UAH-IC-Design-Team/sky130-10-bit-SAR-ADC/images/capacitor_switch2.png

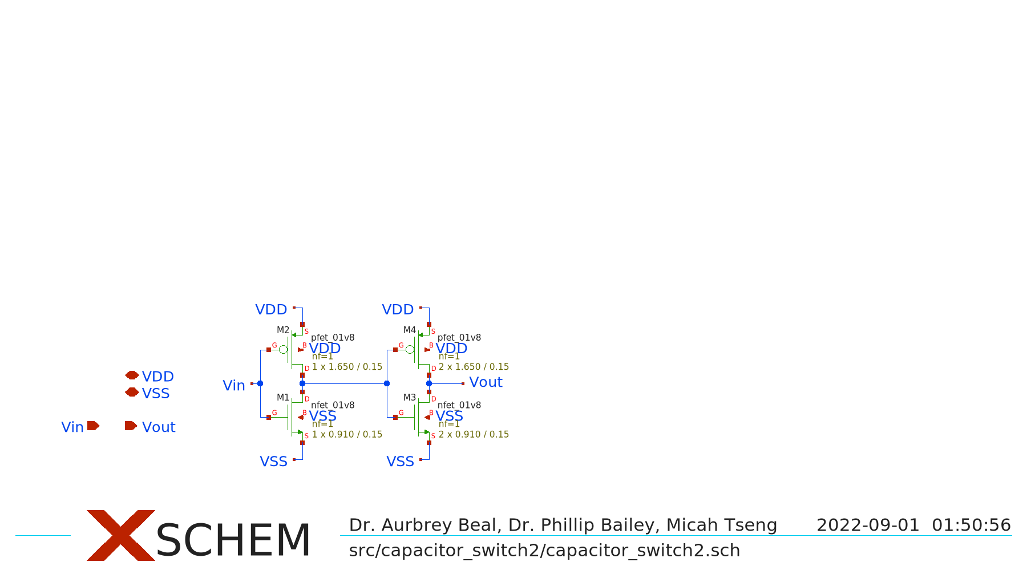
images/capacitor_switch2.png
