UAH-IC-Design-Team/sky130-10-bit-SAR-ADC/images/capacitor_switch8.png

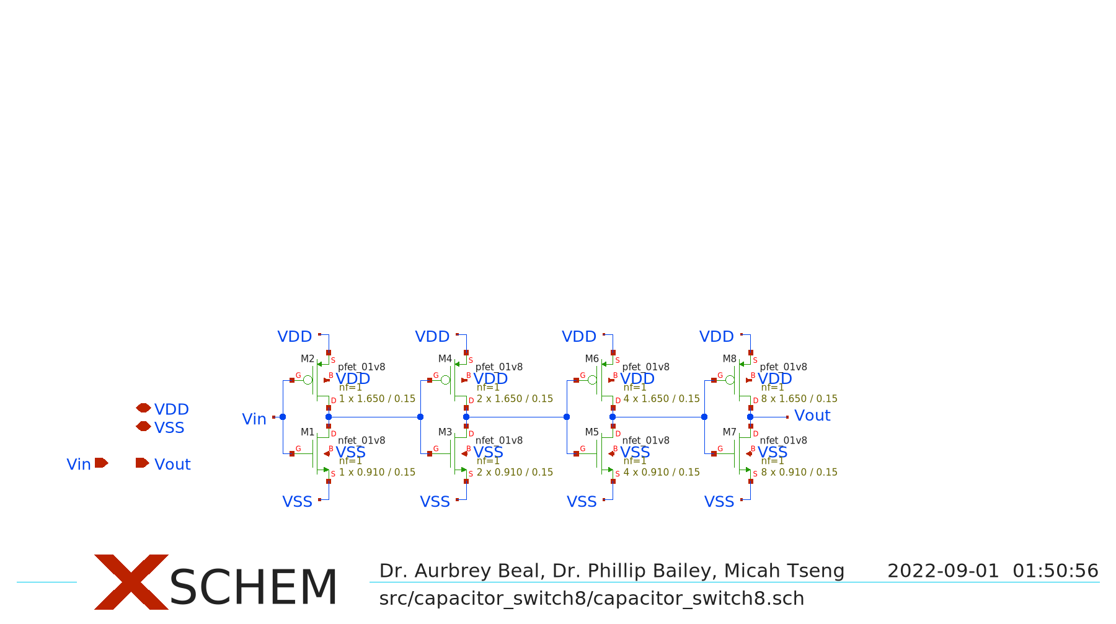
images/capacitor_switch8.png
