UAH-IC-Design-Team/sky130-10-bit-SAR-ADC/images/coherent_sine.png

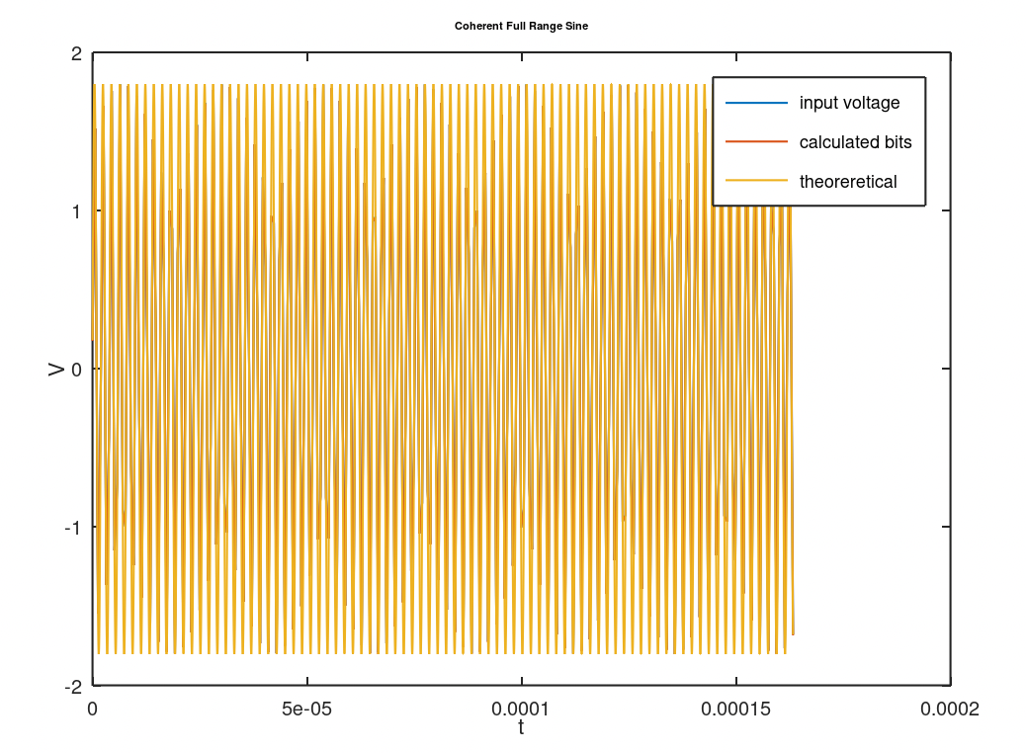
images/coherent_sine.png
