UAH-IC-Design-Team/sky130-10-bit-SAR-ADC/images/dac.png

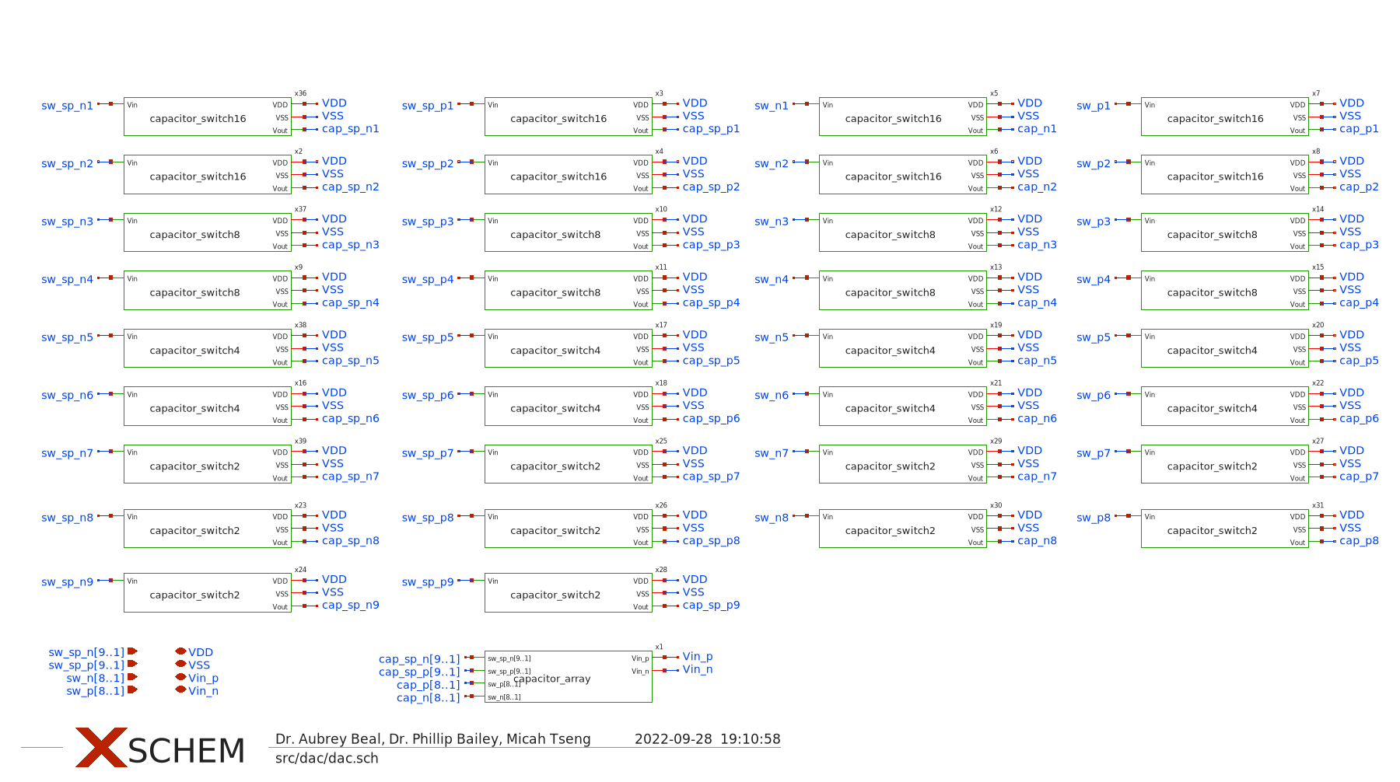
images/dac.png
