UAH-IC-Design-Team/sky130-10-bit-SAR-ADC/images/demux2.png

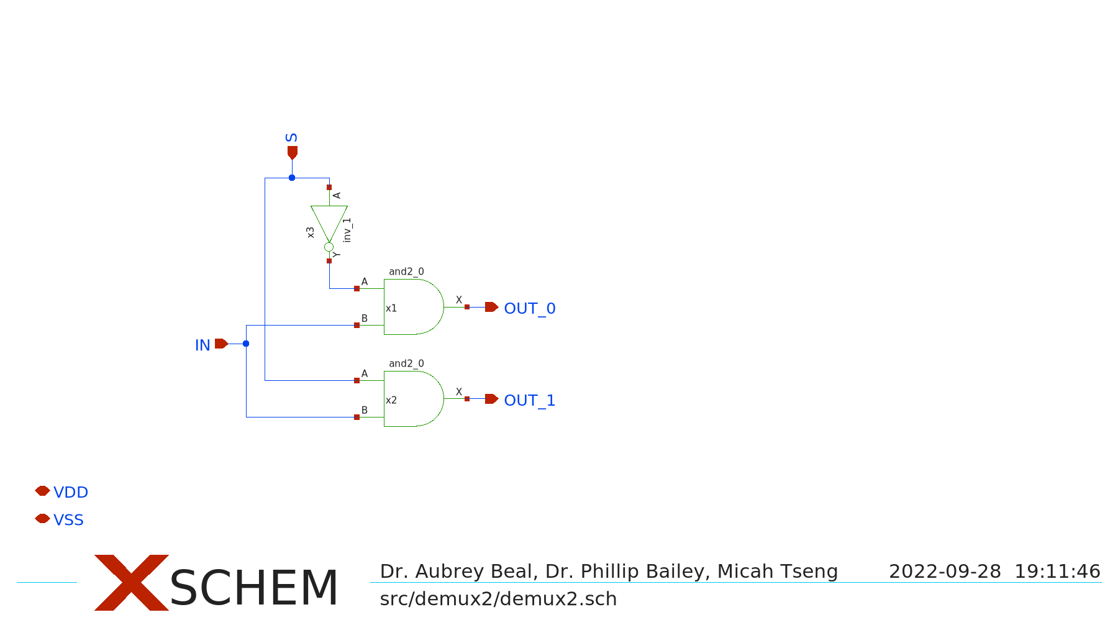
images/demux2.png
