UAH-IC-Design-Team/sky130-10-bit-SAR-ADC/images/raw_bit_calculato2r.png

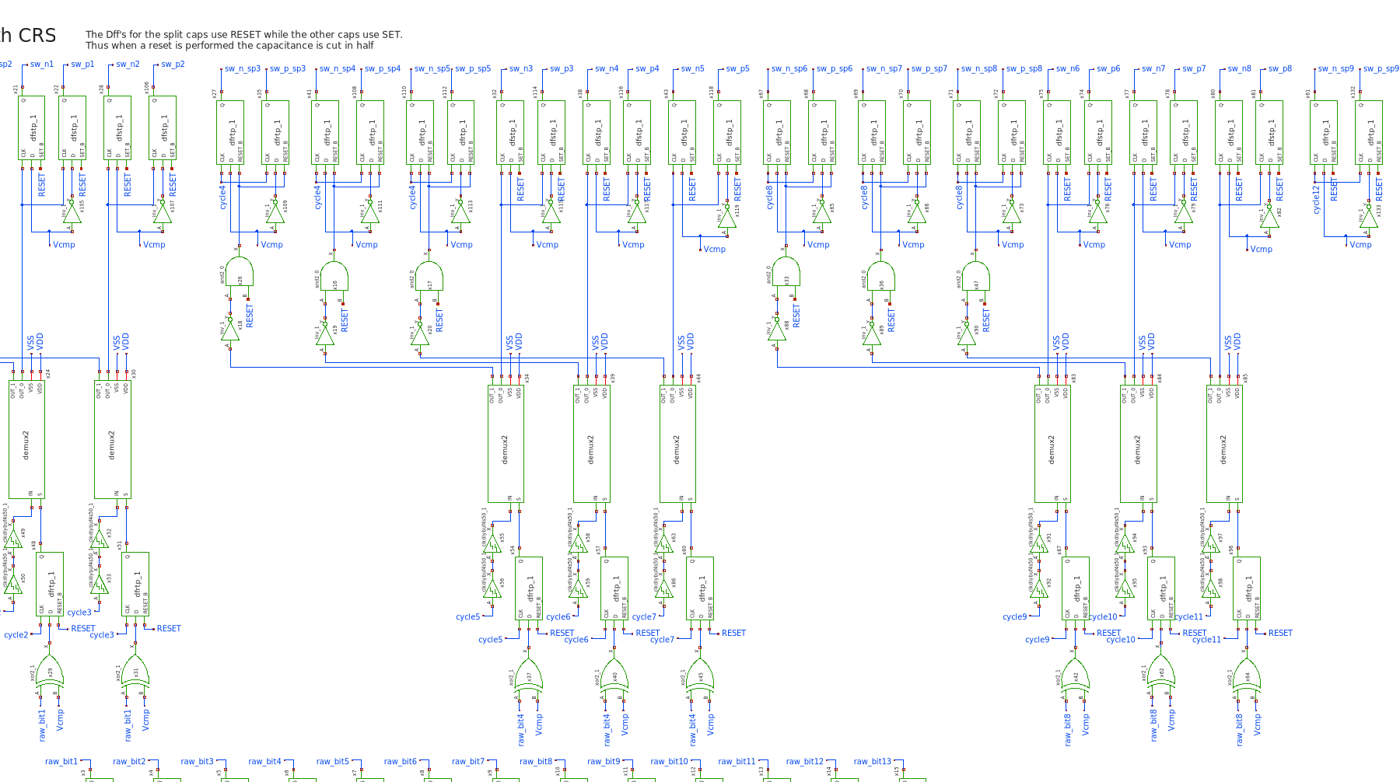
images/raw_bit_calculato2r.png
