UAH-IC-Design-Team/sky130-10-bit-SAR-ADC/images/raw_bit_calculator1.png

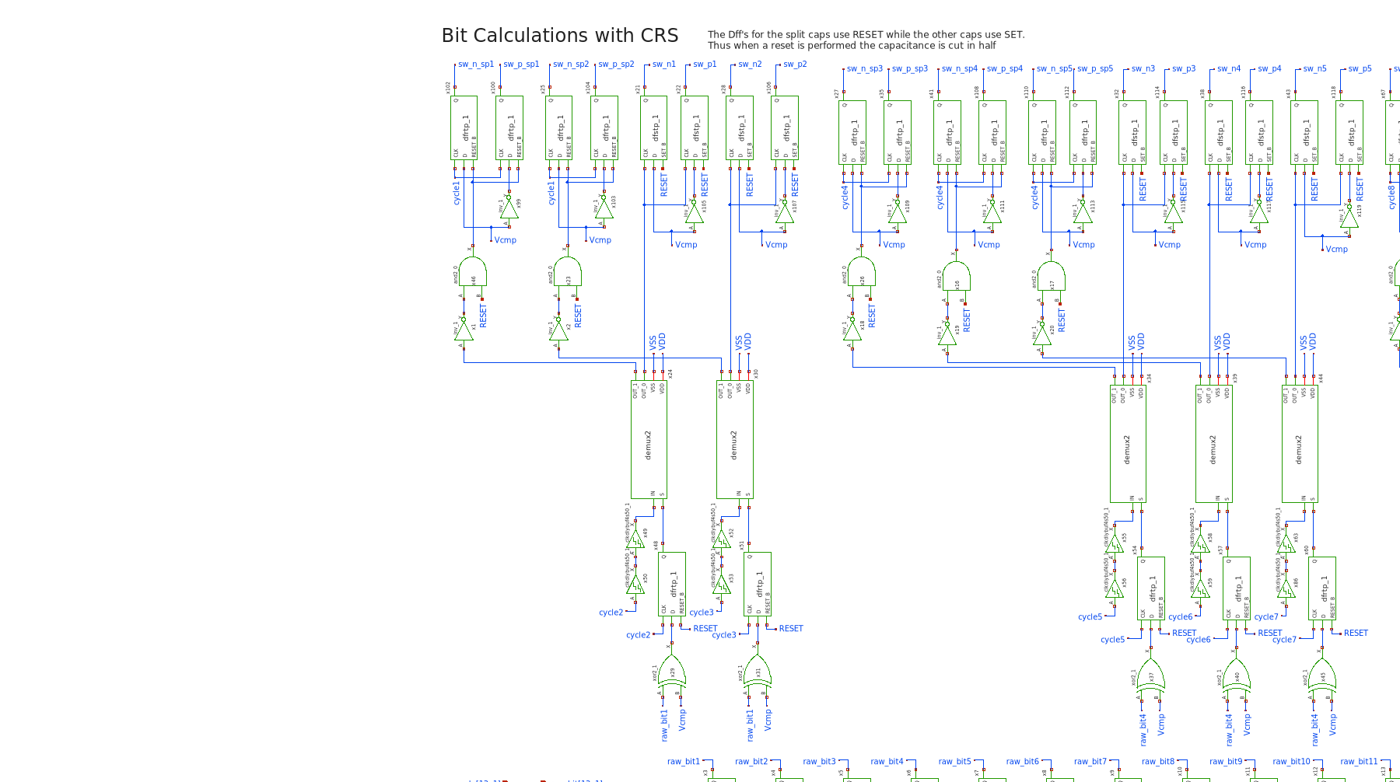
images/raw_bit_calculator1.png
