UAH-IC-Design-Team/sky130-10-bit-SAR-ADC/images/sar_adc.png

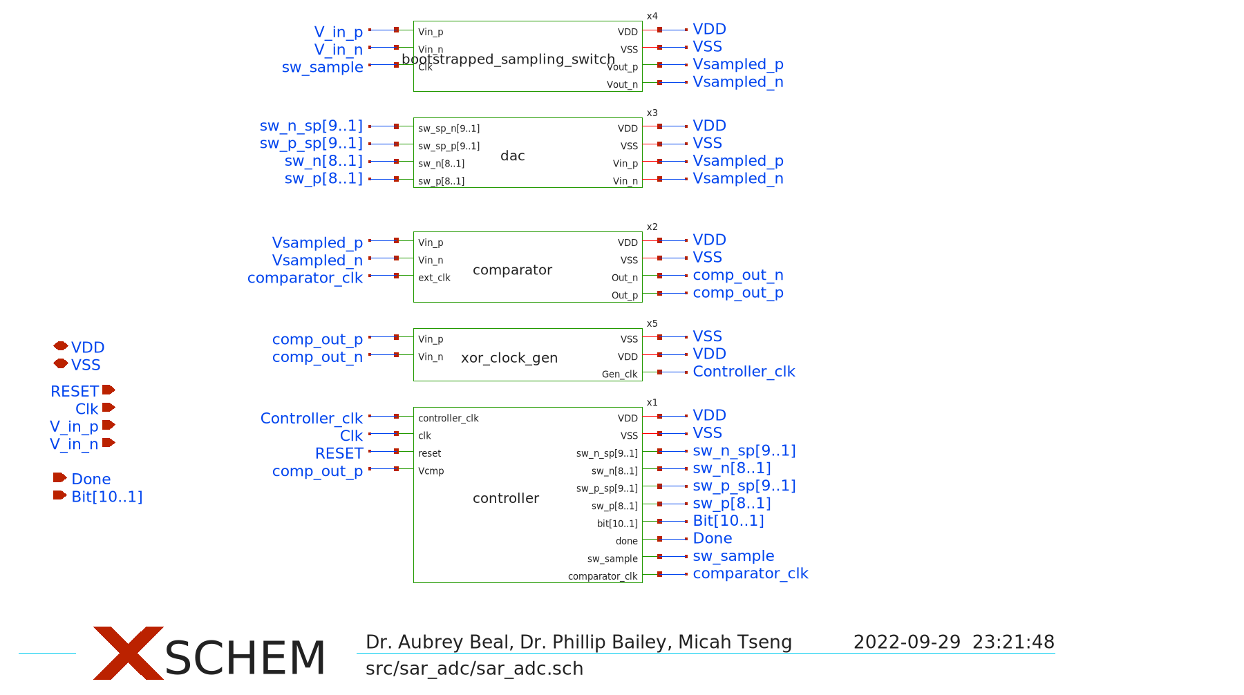
images/sar_adc.png
