UAH-IC-Design-Team/sky130-10-bit-SAR-ADC/images/bootstrapped_sampling_switch_test.png

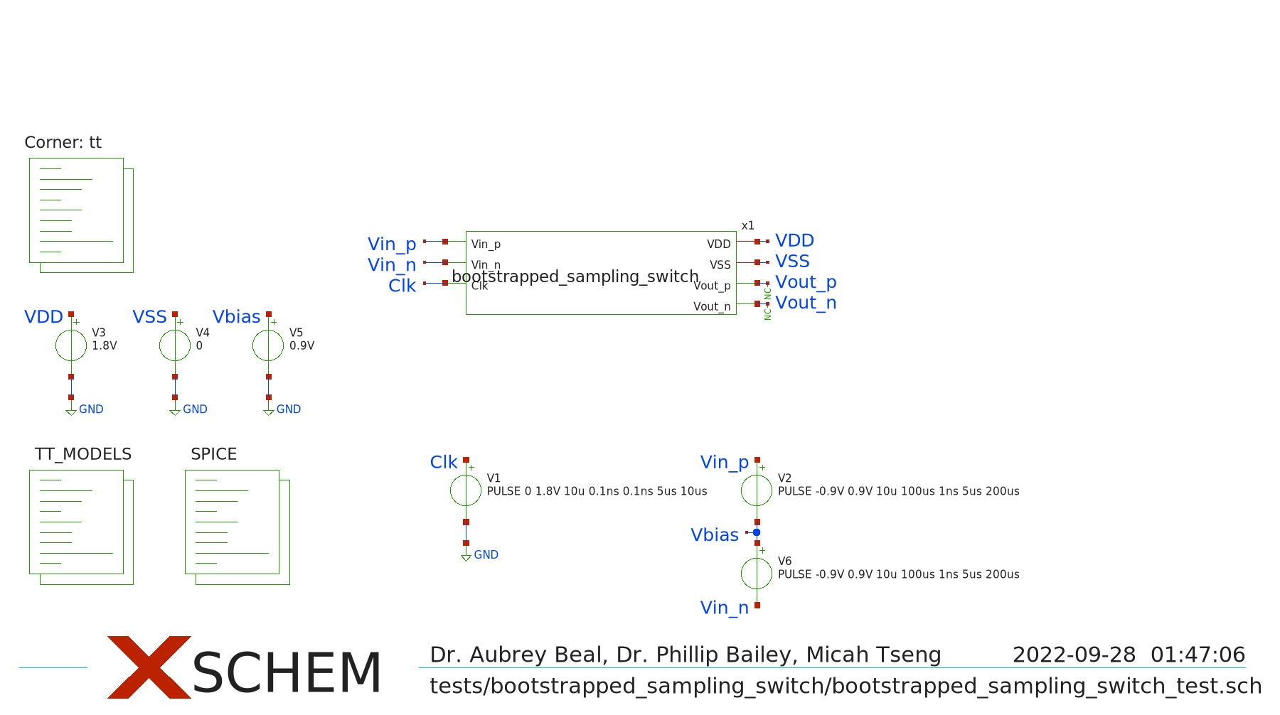
images/bootstrapped_sampling_switch_test.png
