UAH-IC-Design-Team/sky130-10-bit-SAR-ADC/images/capacitor_array_test.png

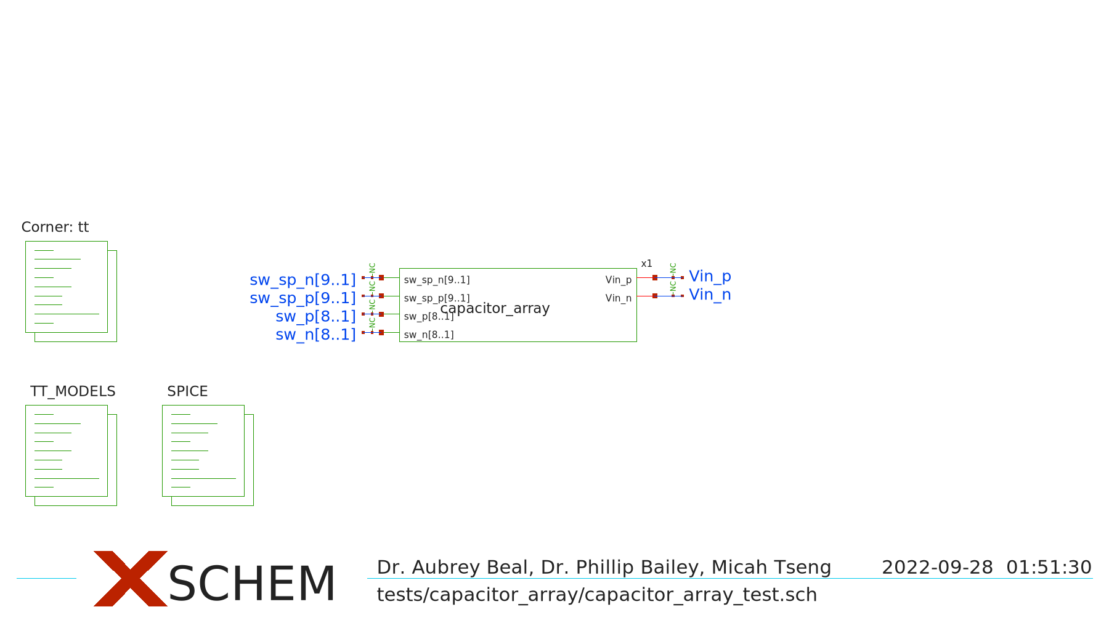
images/capacitor_array_test.png
