UAH-IC-Design-Team/sky130-10-bit-SAR-ADC/images/capacitor_switch2_test.png

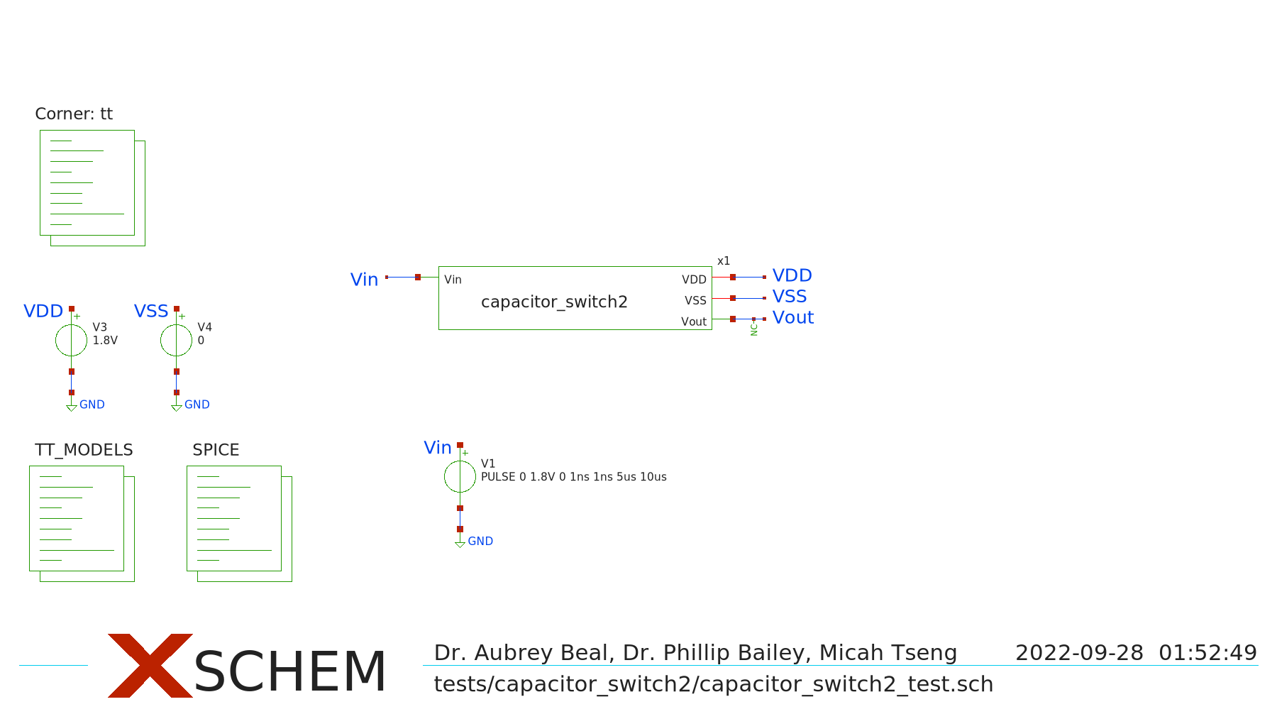
images/capacitor_switch2_test.png
