UAH-IC-Design-Team/sky130-10-bit-SAR-ADC/images/comparator_fast_small_v_test.png

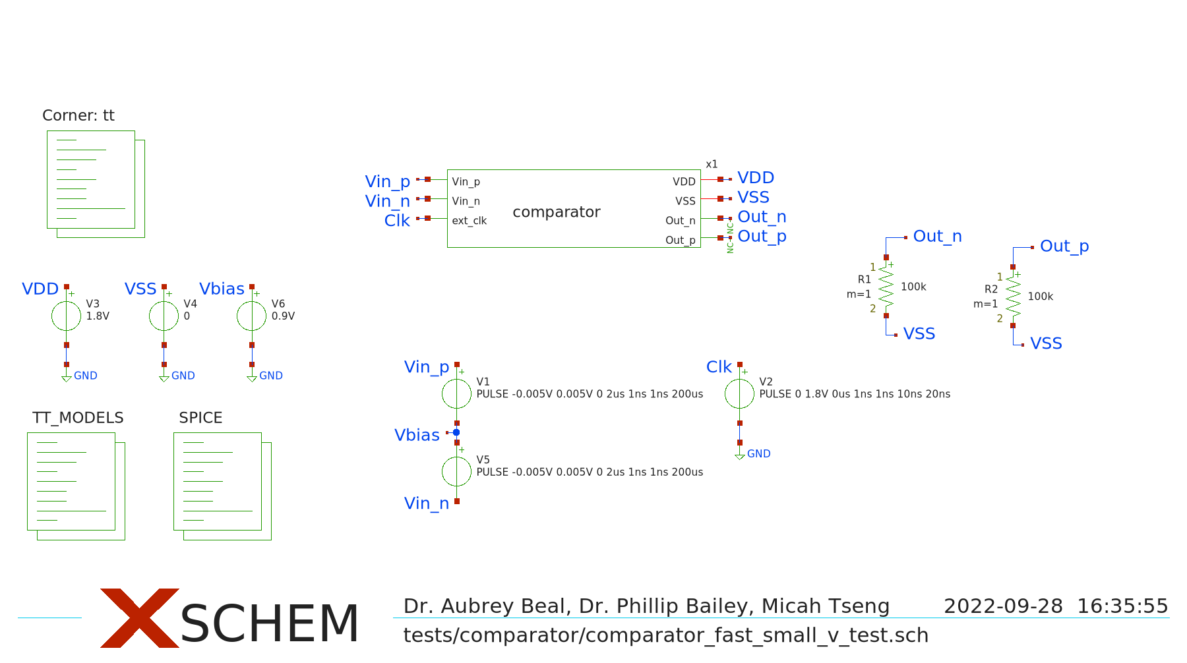
images/comparator_fast_small_v_test.png
