UAH-IC-Design-Team/sky130-10-bit-SAR-ADC/images/controller_corner_ff_test.png

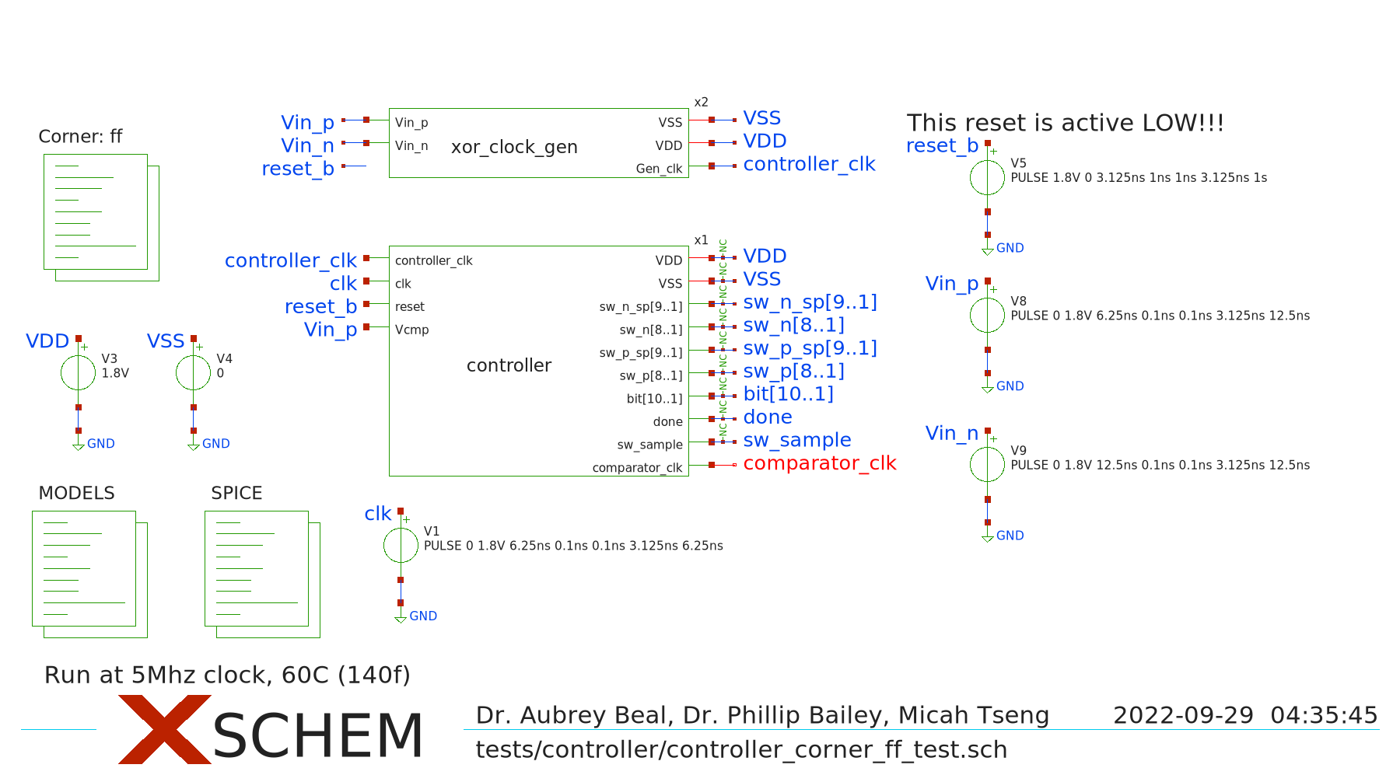
images/controller_corner_ff_test.png
