UAH-IC-Design-Team/sky130-10-bit-SAR-ADC/images/dac_test.png

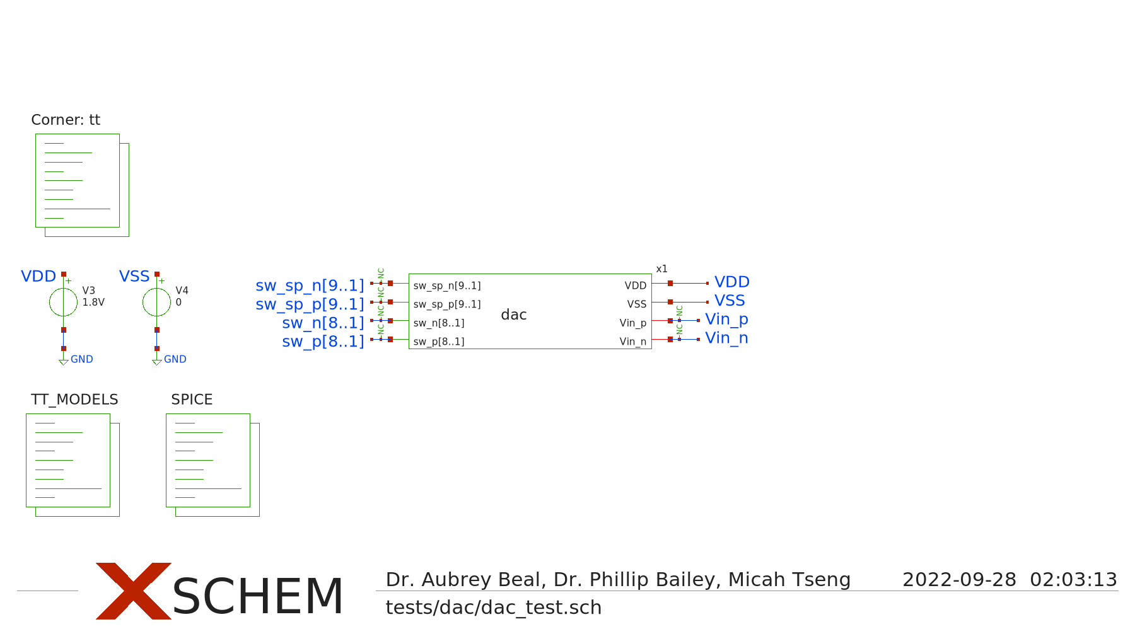
images/dac_test.png
