UAH-IC-Design-Team/sky130-10-bit-SAR-ADC/images/dec_test.png

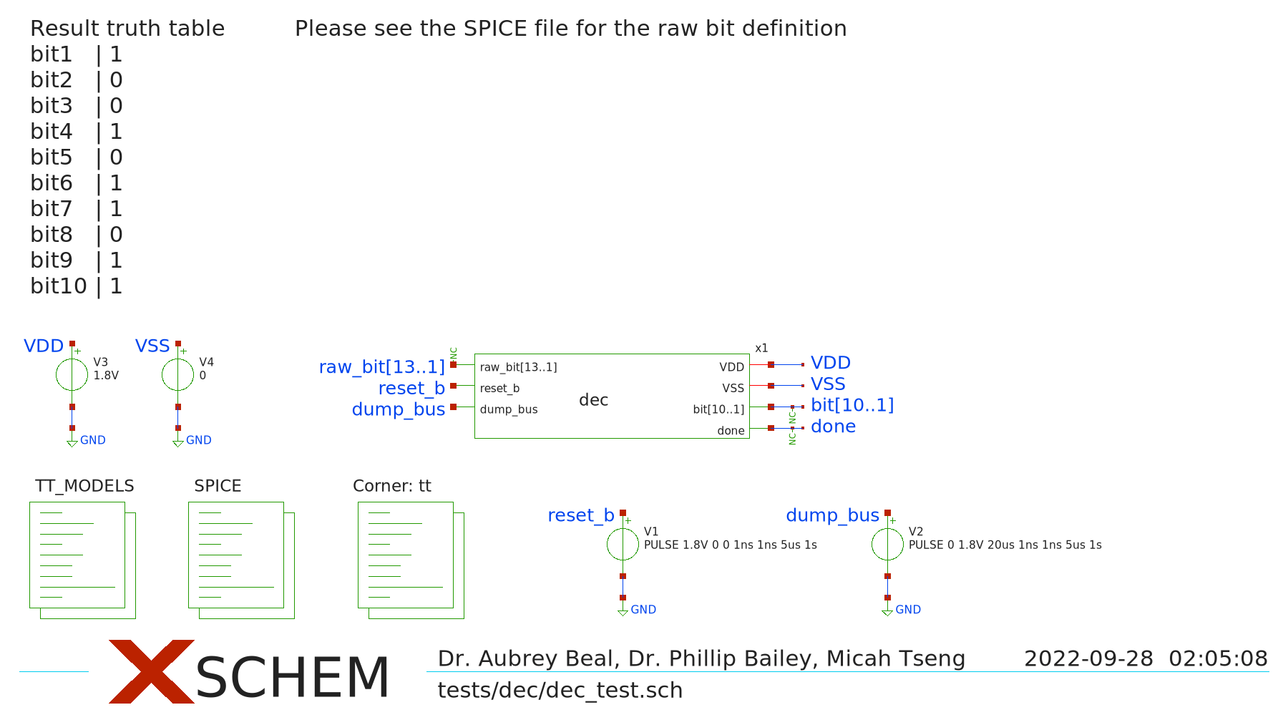
images/dec_test.png
