UAH-IC-Design-Team/sky130-10-bit-SAR-ADC/images/demux2_test.png

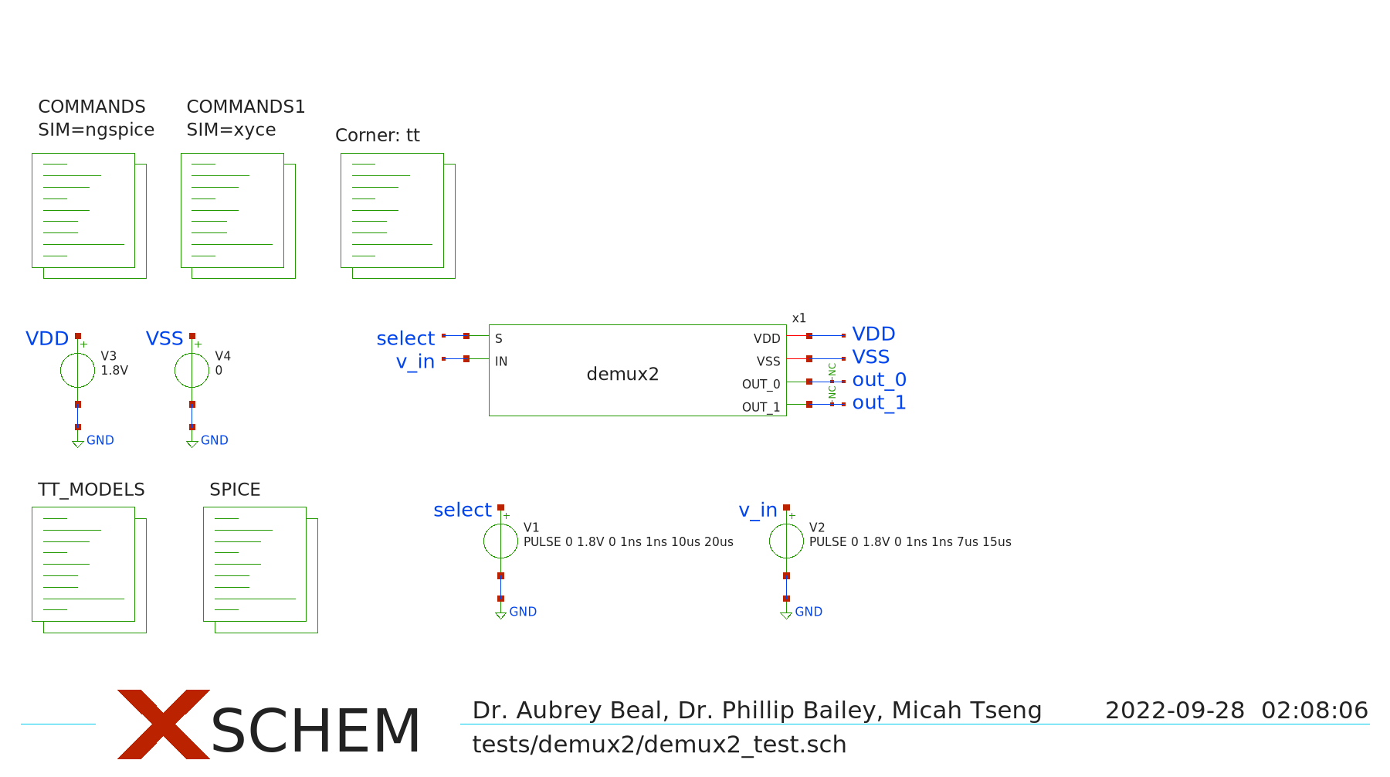
images/demux2_test.png
