UAH-IC-Design-Team/sky130-10-bit-SAR-ADC/images/raw_bit_calculator_test.png

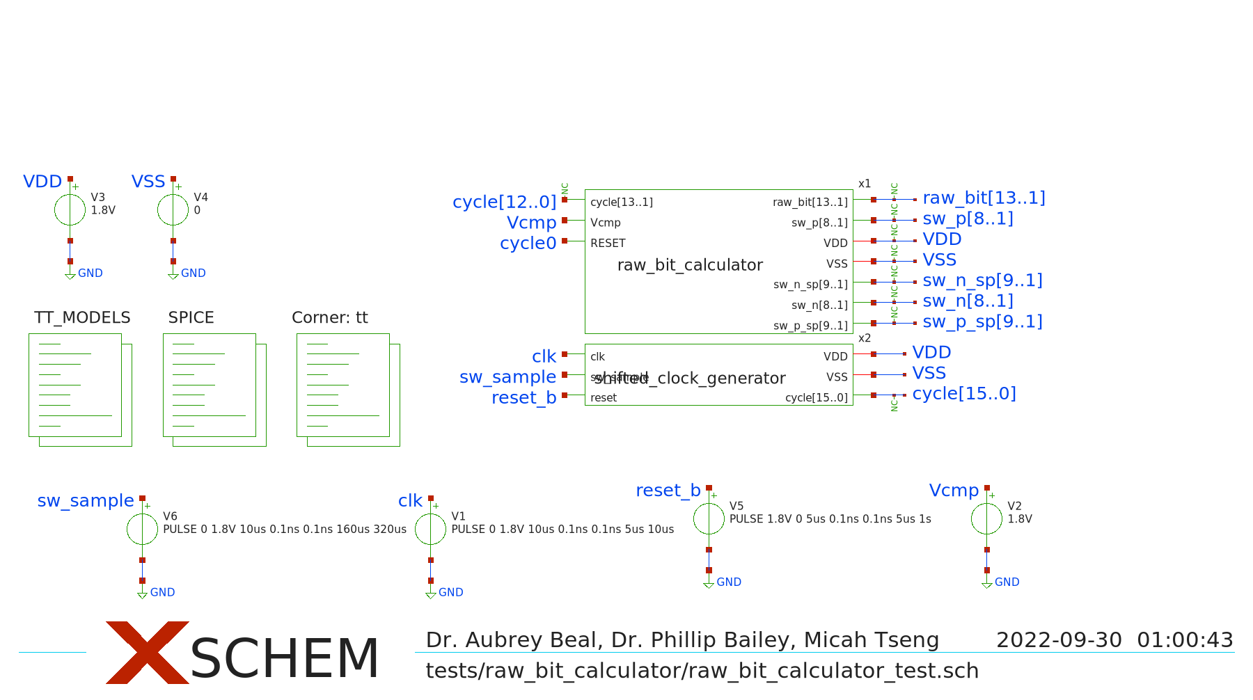
images/raw_bit_calculator_test.png
