UAH-IC-Design-Team/sky130-10-bit-SAR-ADC/images/sample_clock_test.png

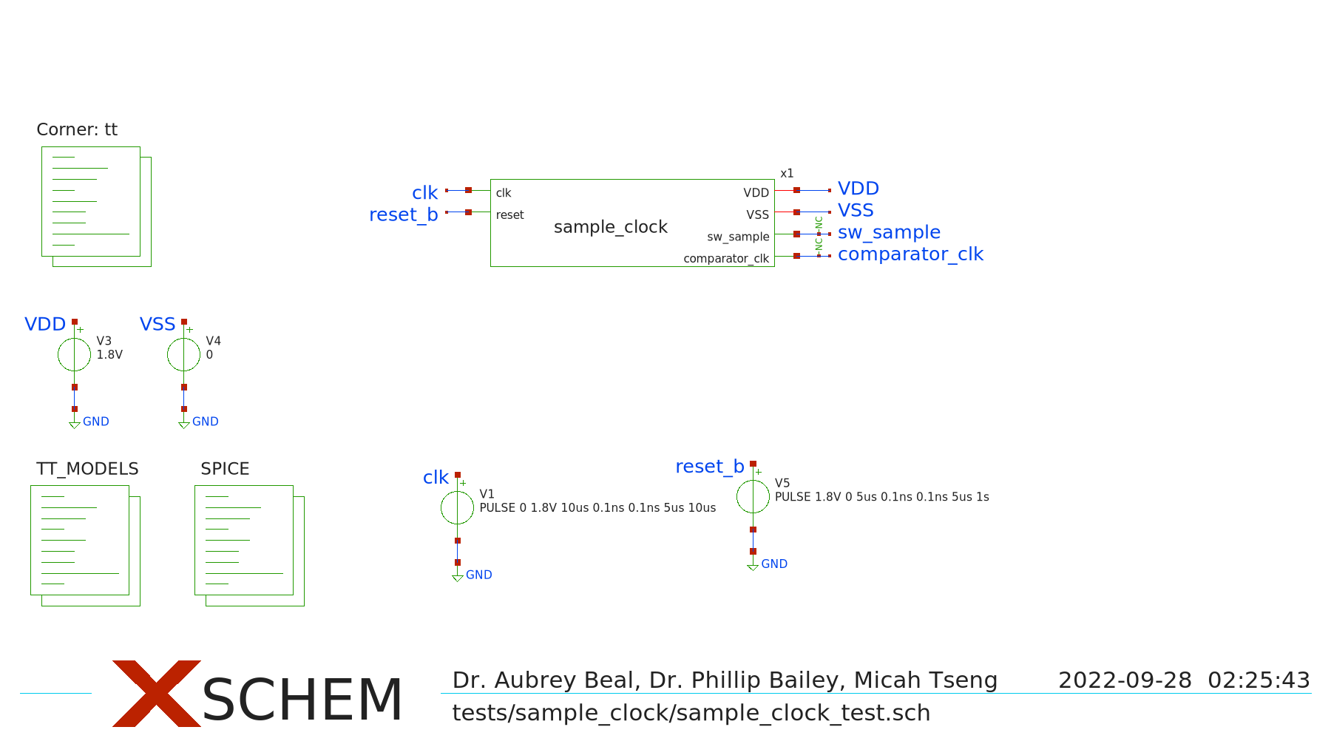
images/sample_clock_test.png
