UAH-IC-Design-Team/sky130-10-bit-SAR-ADC/images/sar_adc_code_step_test.png

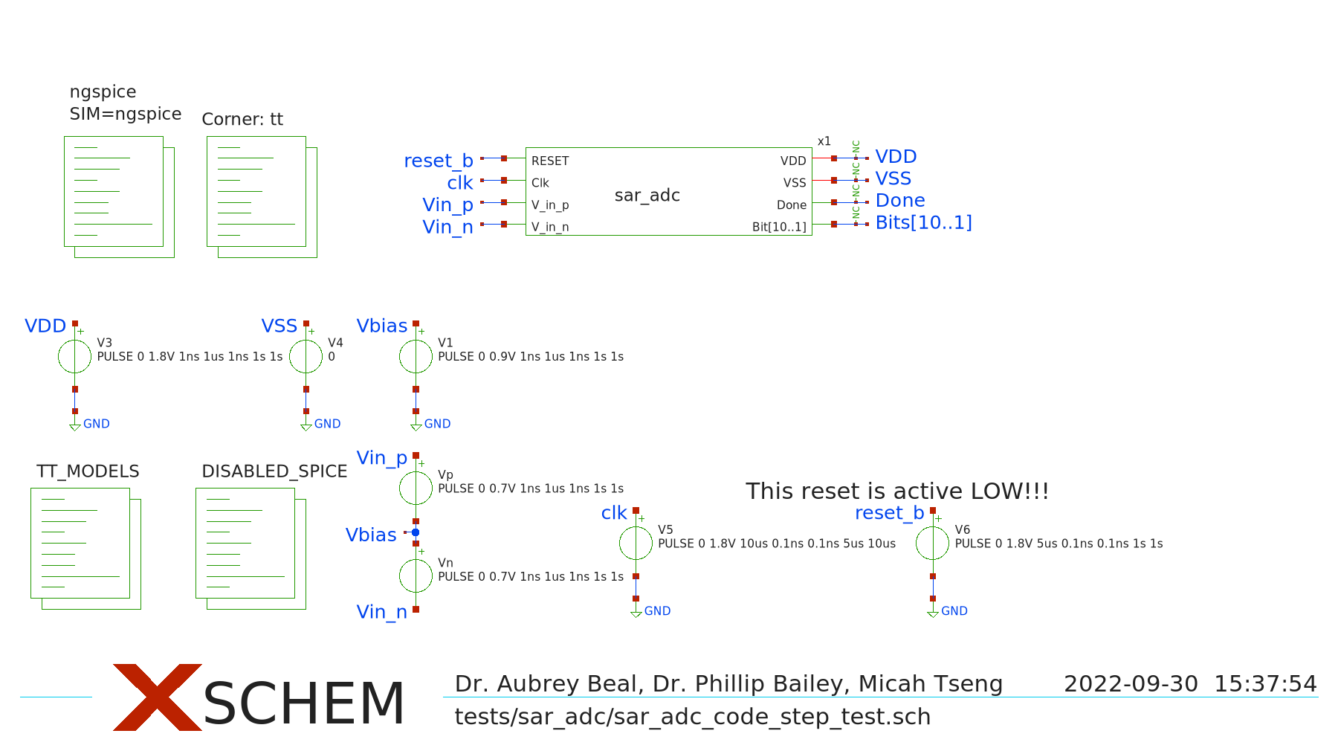
images/sar_adc_code_step_test.png
