UAH-IC-Design-Team/sky130-10-bit-SAR-ADC/images/sar_adc_max_sample_rate_test.png

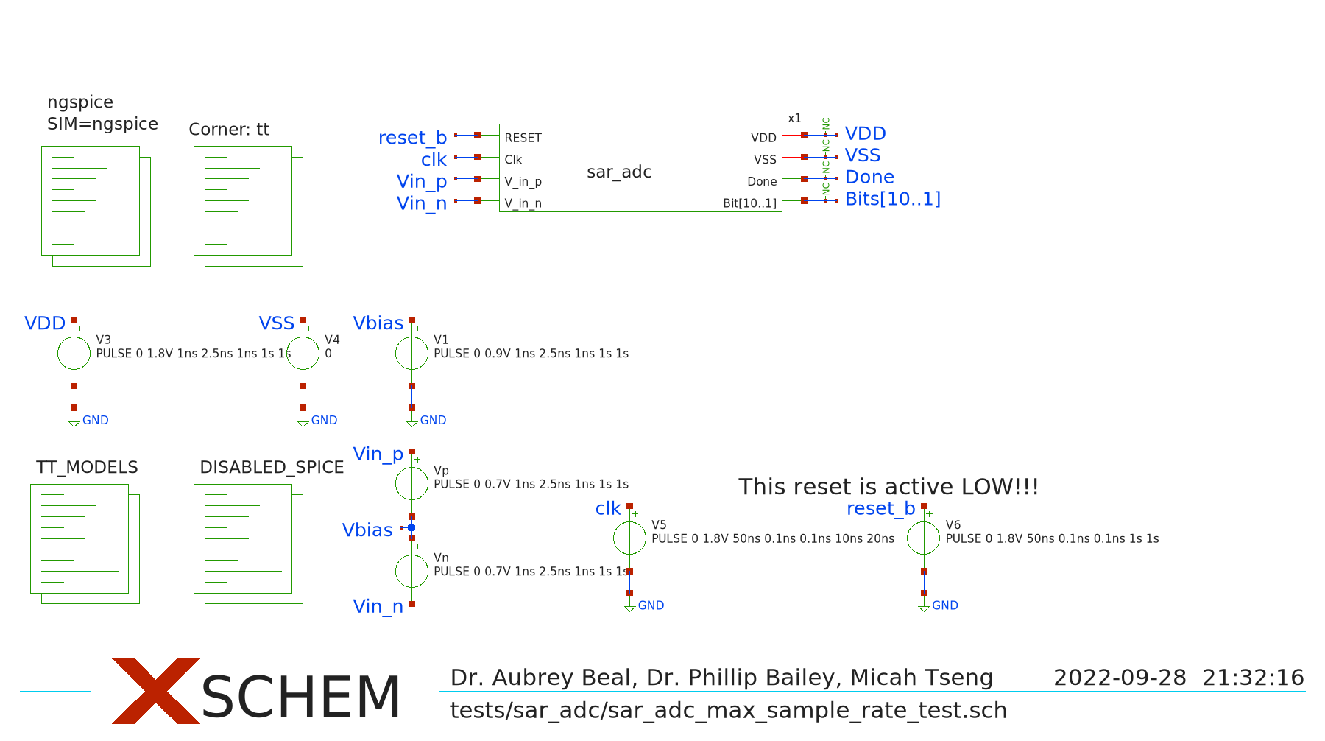
images/sar_adc_max_sample_rate_test.png
