UAH-IC-Design-Team/sky130-10-bit-SAR-ADC/images/shifted_clock_generator_test.png

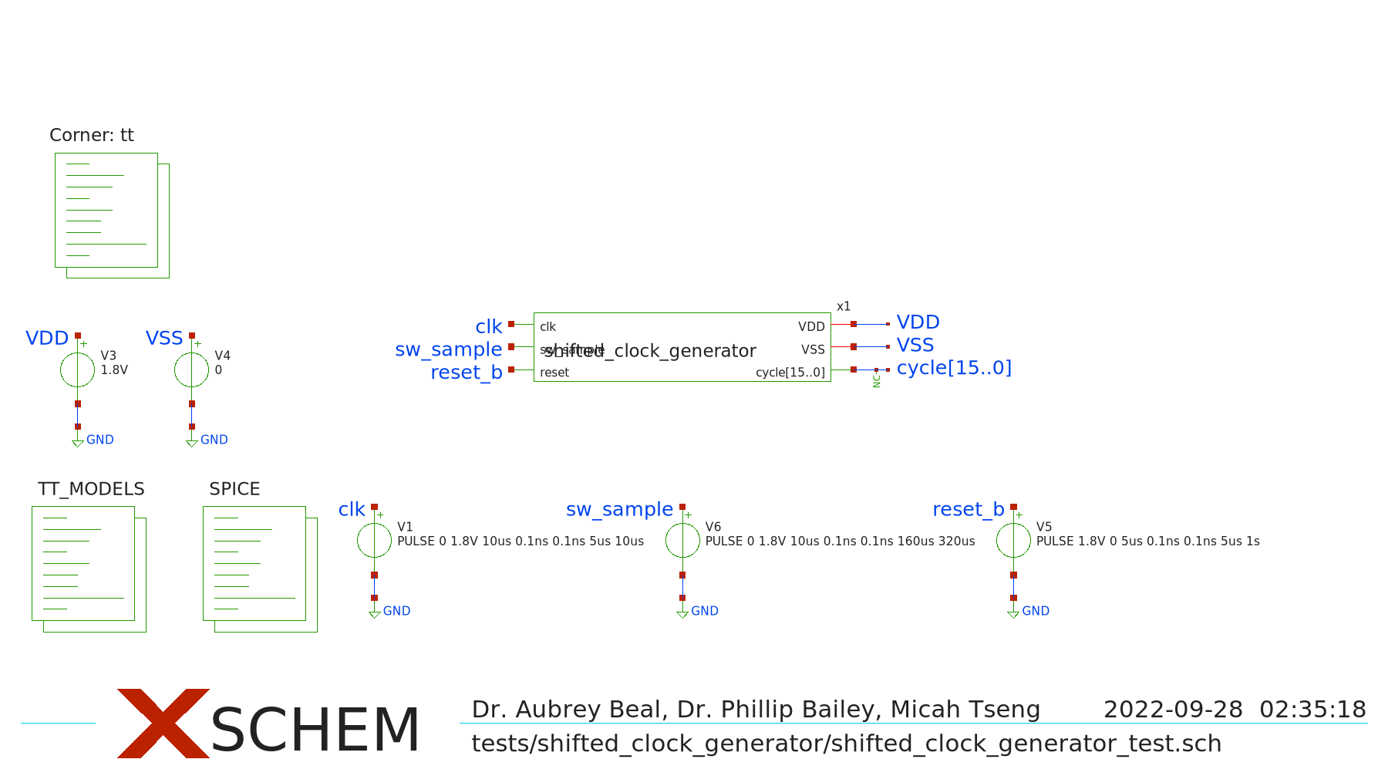
images/shifted_clock_generator_test.png
