UAH-IC-Design-Team/sky130-10-bit-SAR-ADC/images/xor_clock_gen_test.png

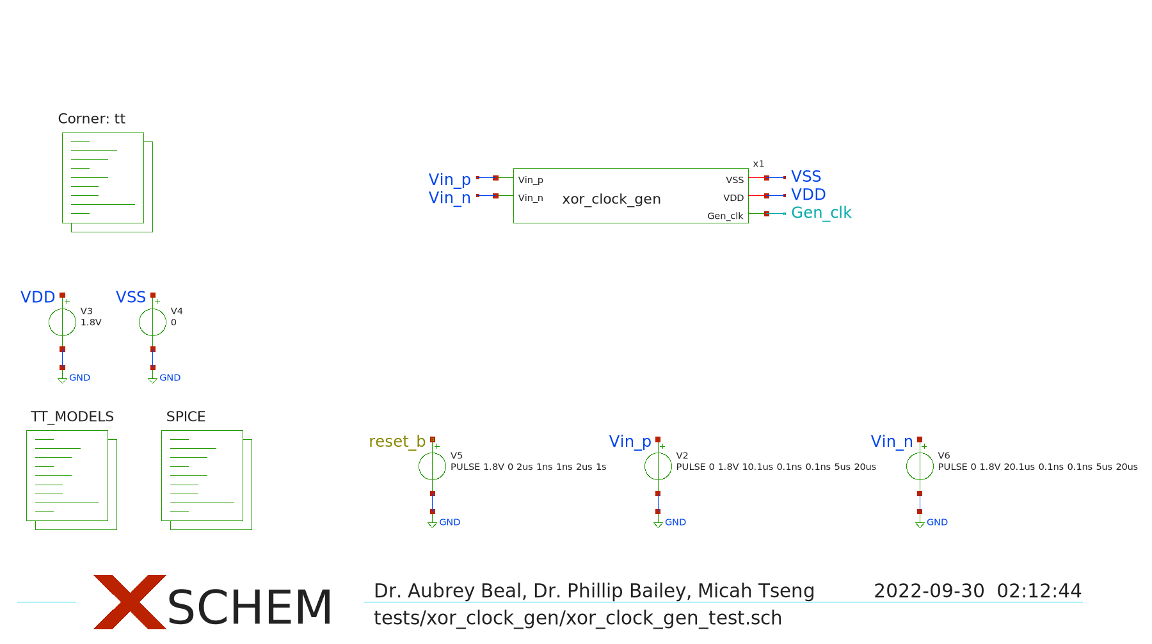
images/xor_clock_gen_test.png
