UAH-IC-Design-Team/sky130-10-bit-SAR-ADC/xschem/tests/sar_adc/sar_adc_test.spice

** sch_path: /foss/designs/sky130-10-bit-SAR-ADC/xschem/tests/sar_adc/sar_adc_test.sch
**.subckt sar_adc_test
V3 VDD GND 1.8V
V4 VSS GND 0
x1 VDD VSS reset_b clk Vin_p Vin_n Done Bits10 Bits9 Bits8 Bits7 Bits6 Bits5 Bits4 Bits3 Bits2 Bits1
+ sar_adc
V2 Vbias Vin_n 0.7
V5 clk GND PULSE 0 1.8V 10us 0.1ns 0.1ns 5us 10us
V6 reset_b GND PULSE 1.8V 0 5us 0.1ns 0.1ns 5us 1s
V1 Vbias GND 0.9V
V7 Vin_p Vbias 0.7
**** begin user architecture code
 .lib /foss/pdk/sky130A/libs.tech/ngspice/sky130.lib.spice tt
.include /foss/pdk/sky130A/libs.ref/sky130_fd_sc_hd/spice/sky130_fd_sc_hd.spice


.options acct list
.temp 25
*vvcc VDD 0 dc 1.8
*vvss VSS 0 0
.control
tran 0.2u 400u
*plot RST_PLS clk+2 Pulse+4
*plot Done-4 Vin_p-Vin_n-2 bits1 bits2+2 bits3+4 bits4+6 bits5+8 bits6+10 bits7+12 bits8+14 bits9+16
*+ bits10+18
*plot x1.vsampled_p x1.vsampled_n x1.vsampled_p-x1.vsampled_n x1.sw_sample-2 x1.comp_out_p+2
write sar_adc_test.raw
.endc


**** end user architecture code
**.ends

* expanding   symbol:  src/sar_adc/sar_adc.sym # of pins=8
** sym_path: /foss/designs/sky130-10-bit-SAR-ADC/xschem/src/sar_adc/sar_adc.sym
** sch_path: /foss/designs/sky130-10-bit-SAR-ADC/xschem/src/sar_adc/sar_adc.sch
.subckt sar_adc  VDD VSS RESET Clk V_in_p V_in_n Done Bit10 Bit9 Bit8 Bit7 Bit6 Bit5 Bit4 Bit3 Bit2
+ Bit1
*.iopin VDD
*.ipin V_in_p
*.opin Done
*.iopin VSS
*.ipin V_in_n
*.ipin Clk
*.opin Bit10,Bit9,Bit8,Bit7,Bit6,Bit5,Bit4,Bit3,Bit2,Bit1
*.ipin RESET
x1 VDD VSS sw_n_sp9 sw_n_sp8 sw_n_sp7 sw_n_sp6 sw_n_sp5 sw_n_sp4 sw_n_sp3 sw_n_sp2 sw_n_sp1
+ Controller_clk RESET sw_n8 sw_n7 sw_n6 sw_n5 sw_n4 sw_n3 sw_n2 sw_n1 Vcomp_q sw_p_sp9 sw_p_sp8 sw_p_sp7 sw_p_sp6
+ sw_p_sp5 sw_p_sp4 sw_p_sp3 sw_p_sp2 sw_p_sp1 sw_p8 sw_p7 sw_p6 sw_p5 sw_p4 sw_p3 sw_p2 sw_p1 Bit10 Bit9 Bit8
+ Bit7 Bit6 Bit5 Bit4 Bit3 Bit2 Bit1 Done sw_sample controller
x2 VDD VSS Vsampled_p comp_out_n Vsampled_n comp_out_p Clk comparator
x3 sw_n_sp9 sw_n_sp8 sw_n_sp7 sw_n_sp6 sw_n_sp5 sw_n_sp4 sw_n_sp3 sw_n_sp2 sw_n_sp1 VDD sw_p_sp9
+ sw_p_sp8 sw_p_sp7 sw_p_sp6 sw_p_sp5 sw_p_sp4 sw_p_sp3 sw_p_sp2 sw_p_sp1 VSS sw_n8 sw_n7 sw_n6 sw_n5 sw_n4
+ sw_n3 sw_n2 sw_n1 Vsampled_p sw_p8 sw_p7 sw_p6 sw_p5 sw_p4 sw_p3 sw_p2 sw_p1 Vsampled_n dac
x4 VDD V_in_p VSS V_in_n sw_sample Vsampled_p Vsampled_n bootstrapped_sampling_switch
x5 VSS comp_out_p VDD comp_out_n Controller_clk Clk Vcomp_q RESET xor_clock_gen
.ends


* expanding   symbol:  src/controller/controller.sym # of pins=12
** sym_path: /foss/designs/sky130-10-bit-SAR-ADC/xschem/src/controller/controller.sym
** sch_path: /foss/designs/sky130-10-bit-SAR-ADC/xschem/src/controller/controller.sch
.subckt controller  VDD VSS sw_n_sp9 sw_n_sp8 sw_n_sp7 sw_n_sp6 sw_n_sp5 sw_n_sp4 sw_n_sp3 sw_n_sp2
+ sw_n_sp1 clk reset sw_n8 sw_n7 sw_n6 sw_n5 sw_n4 sw_n3 sw_n2 sw_n1 Vcmp sw_p_sp9 sw_p_sp8 sw_p_sp7 sw_p_sp6
+ sw_p_sp5 sw_p_sp4 sw_p_sp3 sw_p_sp2 sw_p_sp1 sw_p8 sw_p7 sw_p6 sw_p5 sw_p4 sw_p3 sw_p2 sw_p1 bit10 bit9 bit8
+ bit7 bit6 bit5 bit4 bit3 bit2 bit1 done sw_sample
*.ipin clk
*.opin sw_n_sp9,sw_n_sp8,sw_n_sp7,sw_n_sp6,sw_n_sp5,sw_n_sp4,sw_n_sp3,sw_n_sp2,sw_n_sp1
*.iopin VSS
*.iopin VDD
*.ipin reset
*.ipin Vcmp
*.opin sw_n8,sw_n7,sw_n6,sw_n5,sw_n4,sw_n3,sw_n2,sw_n1
*.opin sw_p_sp9,sw_p_sp8,sw_p_sp7,sw_p_sp6,sw_p_sp5,sw_p_sp4,sw_p_sp3,sw_p_sp2,sw_p_sp1
*.opin sw_p8,sw_p7,sw_p6,sw_p5,sw_p4,sw_p3,sw_p2,sw_p1
*.opin bit10,bit9,bit8,bit7,bit6,bit5,bit4,bit3,bit2,bit1
*.opin done
*.opin sw_sample
x95 cycle1 cycle2 cycle3 cycle4 VSS VSS VDD VDD net1 sky130_fd_sc_hd__or4_2
x96 cycle5 cycle6 cycle7 cycle8 VSS VSS VDD VDD net2 sky130_fd_sc_hd__or4_2
x97 cycle9 cycle10 cycle11 cycle12 VSS VSS VDD VDD net4 sky130_fd_sc_hd__or4_2
x3 VDD raw_bit13 raw_bit12 raw_bit11 raw_bit10 raw_bit9 raw_bit8 raw_bit7 raw_bit6 raw_bit5 raw_bit4
+ raw_bit3 raw_bit2 raw_bit1 VSS reset bit10 bit9 bit8 bit7 bit6 bit5 bit4 bit3 bit2 bit1 done cycle31 dec
x4 raw_bit13 raw_bit12 raw_bit11 raw_bit10 raw_bit9 raw_bit8 raw_bit7 raw_bit6 raw_bit5 raw_bit4
+ raw_bit3 raw_bit2 raw_bit1 cycle30 cycle29 cycle28 cycle27 cycle26 cycle25 cycle24 cycle23 cycle22 cycle21
+ cycle20 cycle19 cycle18 sw_p8 sw_p7 sw_p6 sw_p5 sw_p4 sw_p3 sw_p2 sw_p1 Vcmp cycle0 VDD VSS sw_n_sp9
+ sw_n_sp8 sw_n_sp7 sw_n_sp6 sw_n_sp5 sw_n_sp4 sw_n_sp3 sw_n_sp2 sw_n_sp1 sw_n8 sw_n7 sw_n6 sw_n5 sw_n4 sw_n3
+ sw_n2 sw_n1 sw_p_sp9 sw_p_sp8 sw_p_sp7 sw_p_sp6 sw_p_sp5 sw_p_sp4 sw_p_sp3 sw_p_sp2 sw_p_sp1
+ raw_bit_calculator
x1 clk VDD VSS reset cycle31 cycle30 cycle29 cycle28 cycle27 cycle26 cycle25 cycle24 cycle23 cycle22
+ cycle21 cycle20 cycle19 cycle18 cycle17 cycle16 cycle15 cycle14 cycle13 cycle12 cycle11 cycle10 cycle9
+ cycle8 cycle7 cycle6 cycle5 cycle4 cycle3 cycle2 cycle1 cycle0 shifted_clock_generator
x8 net1 net2 net4 net3 VSS VSS VDD VDD net5 sky130_fd_sc_hd__or4_2
x9 clk net5 reset VSS VSS VDD VDD sw_sample sky130_fd_sc_hd__dfrtn_1
x10 cycle13 cycle14 cycle15 VSS VSS VDD VDD net3 sky130_fd_sc_hd__or3_2
.ends


* expanding   symbol:  src/comparator/comparator.sym # of pins=7
** sym_path: /foss/designs/sky130-10-bit-SAR-ADC/xschem/src/comparator/comparator.sym
** sch_path: /foss/designs/sky130-10-bit-SAR-ADC/xschem/src/comparator/comparator.sch
.subckt comparator  VDD VSS Vin_p Out_n Vin_n Out_p Clk
*.iopin VDD
*.iopin VSS
*.ipin Vin_p
*.opin Out_n
*.ipin Vin_n
*.opin Out_p
*.ipin Clk
XM1 Pre_Amp_p Clk_n VDD VDD sky130_fd_pr__pfet_01v8 L=0.15 W=50 nf=2 ad='int((nf+1)/2) * W/nf * 0.29'
+ as='int((nf+2)/2) * W/nf * 0.29' pd='2*int((nf+1)/2) * (W/nf + 0.29)' ps='2*int((nf+2)/2) * (W/nf + 0.29)'
+ nrd='0.29 / W' nrs='0.29 / W' sa=0 sb=0 sd=0 mult=1 m=1
XM2 Pre_Amp_n Clk_n VDD VDD sky130_fd_pr__pfet_01v8 L=0.15 W=50 nf=2 ad='int((nf+1)/2) * W/nf * 0.29'
+ as='int((nf+2)/2) * W/nf * 0.29' pd='2*int((nf+1)/2) * (W/nf + 0.29)' ps='2*int((nf+2)/2) * (W/nf + 0.29)'
+ nrd='0.29 / W' nrs='0.29 / W' sa=0 sb=0 sd=0 mult=1 m=1
XM3 Pre_Amp_n Vin_p net1 VSS sky130_fd_pr__nfet_01v8 L=0.15 W=50 nf=2 ad='int((nf+1)/2) * W/nf * 0.29'
+ as='int((nf+2)/2) * W/nf * 0.29' pd='2*int((nf+1)/2) * (W/nf + 0.29)' ps='2*int((nf+2)/2) * (W/nf + 0.29)'
+ nrd='0.29 / W' nrs='0.29 / W' sa=0 sb=0 sd=0 mult=10 m=10
XM4 Pre_Amp_p Vin_n net1 VSS sky130_fd_pr__nfet_01v8 L=0.15 W=50 nf=2 ad='int((nf+1)/2) * W/nf * 0.29'
+ as='int((nf+2)/2) * W/nf * 0.29' pd='2*int((nf+1)/2) * (W/nf + 0.29)' ps='2*int((nf+2)/2) * (W/nf + 0.29)'
+ nrd='0.29 / W' nrs='0.29 / W' sa=0 sb=0 sd=0 mult=10 m=10
XM5 net3 net5 VDD VDD sky130_fd_pr__pfet_01v8 L=0.15 W=1.605 nf=1 ad='int((nf+1)/2) * W/nf * 0.29' as='int((nf+2)/2) * W/nf * 0.29'
+ pd='2*int((nf+1)/2) * (W/nf + 0.29)' ps='2*int((nf+2)/2) * (W/nf + 0.29)' nrd='0.29 / W' nrs='0.29 / W'
+ sa=0 sb=0 sd=0 mult=16 m=16
XM6 net2 net4 VDD VDD sky130_fd_pr__pfet_01v8 L=0.15 W=1.605 nf=1 ad='int((nf+1)/2) * W/nf * 0.29' as='int((nf+2)/2) * W/nf * 0.29'
+ pd='2*int((nf+1)/2) * (W/nf + 0.29)' ps='2*int((nf+2)/2) * (W/nf + 0.29)' nrd='0.29 / W' nrs='0.29 / W'
+ sa=0 sb=0 sd=0 mult=16 m=16
XM9 net1 Clk VSS VSS sky130_fd_pr__nfet_01v8 L=0.15 W=100 nf=5 ad='int((nf+1)/2) * W/nf * 0.29' as='int((nf+2)/2) * W/nf * 0.29'
+ pd='2*int((nf+1)/2) * (W/nf + 0.29)' ps='2*int((nf+2)/2) * (W/nf + 0.29)' nrd='0.29 / W' nrs='0.29 / W'
+ sa=0 sb=0 sd=0 mult=10 m=10
XM11 net4 Clk_n VSS VSS sky130_fd_pr__nfet_01v8 L=0.15 W=0.91 nf=1 ad='int((nf+1)/2) * W/nf * 0.29' as='int((nf+2)/2) * W/nf * 0.29'
+ pd='2*int((nf+1)/2) * (W/nf + 0.29)' ps='2*int((nf+2)/2) * (W/nf + 0.29)' nrd='0.29 / W' nrs='0.29 / W'
+ sa=0 sb=0 sd=0 mult=16 m=16
XM12 net4 net5 VSS VSS sky130_fd_pr__nfet_01v8 L=0.15 W=0.91 nf=1 ad='int((nf+1)/2) * W/nf * 0.29' as='int((nf+2)/2) * W/nf * 0.29'
+ pd='2*int((nf+1)/2) * (W/nf + 0.29)' ps='2*int((nf+2)/2) * (W/nf + 0.29)' nrd='0.29 / W' nrs='0.29 / W'
+ sa=0 sb=0 sd=0 mult=16 m=16
XM13 net5 net4 VSS VSS sky130_fd_pr__nfet_01v8 L=0.15 W=0.91 nf=1 ad='int((nf+1)/2) * W/nf * 0.29' as='int((nf+2)/2) * W/nf * 0.29'
+ pd='2*int((nf+1)/2) * (W/nf + 0.29)' ps='2*int((nf+2)/2) * (W/nf + 0.29)' nrd='0.29 / W' nrs='0.29 / W'
+ sa=0 sb=0 sd=0 mult=16 m=16
XM14 net5 Clk_n VSS VSS sky130_fd_pr__nfet_01v8 L=0.15 W=0.91 nf=1 ad='int((nf+1)/2) * W/nf * 0.29' as='int((nf+2)/2) * W/nf * 0.29'
+ pd='2*int((nf+1)/2) * (W/nf + 0.29)' ps='2*int((nf+2)/2) * (W/nf + 0.29)' nrd='0.29 / W' nrs='0.29 / W'
+ sa=0 sb=0 sd=0 mult=16 m=16
XM15 Clk_n Clk VDD VDD sky130_fd_pr__pfet_01v8 L=0.15 W=1.605 nf=1 ad='int((nf+1)/2) * W/nf * 0.29' as='int((nf+2)/2) * W/nf * 0.29'
+ pd='2*int((nf+1)/2) * (W/nf + 0.29)' ps='2*int((nf+2)/2) * (W/nf + 0.29)' nrd='0.29 / W' nrs='0.29 / W'
+ sa=0 sb=0 sd=0 mult=1 m=1
XM16 Clk_n Clk VSS VSS sky130_fd_pr__nfet_01v8 L=0.15 W=0.910 nf=1 ad='int((nf+1)/2) * W/nf * 0.29' as='int((nf+2)/2) * W/nf * 0.29'
+ pd='2*int((nf+1)/2) * (W/nf + 0.29)' ps='2*int((nf+2)/2) * (W/nf + 0.29)' nrd='0.29 / W' nrs='0.29 / W'
+ sa=0 sb=0 sd=0 mult=1 m=1
XM7 net5 Pre_Amp_n net2 VDD sky130_fd_pr__pfet_01v8 L=0.15 W=1.605 nf=1 ad='int((nf+1)/2) * W/nf * 0.29'
+ as='int((nf+2)/2) * W/nf * 0.29' pd='2*int((nf+1)/2) * (W/nf + 0.29)' ps='2*int((nf+2)/2) * (W/nf + 0.29)'
+ nrd='0.29 / W' nrs='0.29 / W' sa=0 sb=0 sd=0 mult=16 m=16
XM8 net4 Pre_Amp_p net3 VDD sky130_fd_pr__pfet_01v8 L=0.15 W=1.605 nf=1 ad='int((nf+1)/2) * W/nf * 0.29'
+ as='int((nf+2)/2) * W/nf * 0.29' pd='2*int((nf+1)/2) * (W/nf + 0.29)' ps='2*int((nf+2)/2) * (W/nf + 0.29)'
+ nrd='0.29 / W' nrs='0.29 / W' sa=0 sb=0 sd=0 mult=16 m=16
XC1 Pre_Amp_p VSS sky130_fd_pr__cap_mim_m3_1 W=25 L=25 MF=2 m=2
XC2 Pre_Amp_n VSS sky130_fd_pr__cap_mim_m3_1 W=25 L=25 MF=2 m=2
x1 net4 VSS VSS VDD VDD net6 sky130_fd_sc_hd__buf_1
x2 net6 VSS VSS VDD VDD net7 sky130_fd_sc_hd__buf_4
x3 net7 VSS VSS VDD VDD Out_n sky130_fd_sc_hd__buf_8
x4 net5 VSS VSS VDD VDD net8 sky130_fd_sc_hd__buf_1
x5 net8 VSS VSS VDD VDD net9 sky130_fd_sc_hd__buf_4
x6 net9 VSS VSS VDD VDD Out_p sky130_fd_sc_hd__buf_8
.ends


* expanding   symbol:  src/dac/dac.sym # of pins=8
** sym_path: /foss/designs/sky130-10-bit-SAR-ADC/xschem/src/dac/dac.sym
** sch_path: /foss/designs/sky130-10-bit-SAR-ADC/xschem/src/dac/dac.sch
.subckt dac  sw_sp_n9 sw_sp_n8 sw_sp_n7 sw_sp_n6 sw_sp_n5 sw_sp_n4 sw_sp_n3 sw_sp_n2 sw_sp_n1 VDD
+ sw_sp_p9 sw_sp_p8 sw_sp_p7 sw_sp_p6 sw_sp_p5 sw_sp_p4 sw_sp_p3 sw_sp_p2 sw_sp_p1 VSS sw_n8 sw_n7 sw_n6 sw_n5
+ sw_n4 sw_n3 sw_n2 sw_n1 Vin_p sw_p8 sw_p7 sw_p6 sw_p5 sw_p4 sw_p3 sw_p2 sw_p1 Vin_n
*.iopin VDD
*.ipin sw_sp_n9,sw_sp_n8,sw_sp_n7,sw_sp_n6,sw_sp_n5,sw_sp_n4,sw_sp_n3,sw_sp_n2,sw_sp_n1
*.iopin VSS
*.iopin Vin_p
*.iopin Vin_n
*.ipin sw_sp_p9,sw_sp_p8,sw_sp_p7,sw_sp_p6,sw_sp_p5,sw_sp_p4,sw_sp_p3,sw_sp_p2,sw_sp_p1
*.ipin sw_n8,sw_n7,sw_n6,sw_n5,sw_n4,sw_n3,sw_n2,sw_n1
*.ipin sw_p8,sw_p7,sw_p6,sw_p5,sw_p4,sw_p3,sw_p2,sw_p1
x1 Vin_p cap_sp_n9 cap_sp_n8 cap_sp_n7 cap_sp_n6 cap_sp_n5 cap_sp_n4 cap_sp_n3 cap_sp_n2 cap_sp_n1
+ cap_sp_p9 cap_sp_p8 cap_sp_p7 cap_sp_p6 cap_sp_p5 cap_sp_p4 cap_sp_p3 cap_sp_p2 cap_sp_p1 Vin_n cap_p8 cap_p7
+ cap_p6 cap_p5 cap_p4 cap_p3 cap_p2 cap_p1 cap_n8 cap_n7 cap_n6 cap_n5 cap_n4 cap_n3 cap_n2 cap_n1
+ capacitor_array unit_cap_w=25 unit_cap_l=25
x36 VDD VSS cap_sp_n1 sw_sp_n1 capacitor_switch16
x37 VDD VSS cap_sp_n3 sw_sp_n3 capacitor_switch8
x38 VDD VSS cap_sp_n5 sw_sp_n5 capacitor_switch4
x39 VDD VSS cap_sp_n7 sw_sp_n7 capacitor_switch2
x2 VDD VSS cap_sp_n2 sw_sp_n2 capacitor_switch16
x3 VDD VSS cap_sp_p1 sw_sp_p1 capacitor_switch16
x4 VDD VSS cap_sp_p2 sw_sp_p2 capacitor_switch16
x5 VDD VSS cap_n1 sw_n1 capacitor_switch16
x6 VDD VSS cap_n2 sw_n2 capacitor_switch16
x7 VDD VSS cap_p1 sw_p1 capacitor_switch16
x8 VDD VSS cap_p2 sw_p2 capacitor_switch16
x9 VDD VSS cap_sp_n4 sw_sp_n4 capacitor_switch8
x10 VDD VSS cap_sp_p3 sw_sp_p3 capacitor_switch8
x11 VDD VSS cap_sp_p4 sw_sp_p4 capacitor_switch8
x12 VDD VSS cap_n3 sw_n3 capacitor_switch8
x13 VDD VSS cap_n4 sw_n4 capacitor_switch8
x14 VDD VSS cap_p3 sw_p3 capacitor_switch8
x15 VDD VSS cap_p4 sw_p4 capacitor_switch8
x16 VDD VSS cap_sp_n6 sw_sp_n6 capacitor_switch4
x17 VDD VSS cap_sp_p5 sw_sp_p5 capacitor_switch4
x18 VDD VSS cap_sp_p6 sw_sp_p6 capacitor_switch4
x19 VDD VSS cap_n5 sw_n5 capacitor_switch4
x20 VDD VSS cap_p5 sw_p5 capacitor_switch4
x21 VDD VSS cap_n6 sw_n6 capacitor_switch4
x22 VDD VSS cap_p6 sw_p6 capacitor_switch4
x23 VDD VSS cap_sp_n8 sw_sp_n8 capacitor_switch2
x24 VDD VSS cap_sp_n9 sw_sp_n9 capacitor_switch2
x25 VDD VSS cap_sp_p7 sw_sp_p7 capacitor_switch2
x26 VDD VSS cap_sp_p8 sw_sp_p8 capacitor_switch2
x28 VDD VSS cap_sp_p9 sw_sp_p9 capacitor_switch2
x29 VDD VSS cap_n7 sw_n7 capacitor_switch2
x30 VDD VSS cap_n8 sw_n8 capacitor_switch2
x27 VDD VSS cap_p7 sw_p7 capacitor_switch2
x31 VDD VSS cap_p8 sw_p8 capacitor_switch2
.ends


* expanding   symbol:  src/bootstrapped_sampling_switch/bootstrapped_sampling_switch.sym # of pins=7
** sym_path:
*+ /foss/designs/sky130-10-bit-SAR-ADC/xschem/src/bootstrapped_sampling_switch/bootstrapped_sampling_switch.sym
** sch_path:
*+ /foss/designs/sky130-10-bit-SAR-ADC/xschem/src/bootstrapped_sampling_switch/bootstrapped_sampling_switch.sch
.subckt bootstrapped_sampling_switch  VDD Vin_p VSS Vin_n Clk Vout_p Vout_n
*.iopin VDD
*.ipin Vin_p
*.opin Vout_p
*.iopin VSS
*.opin Vout_n
*.ipin Vin_n
*.ipin Clk
XM1 net3 Clk_n VSS VSS sky130_fd_pr__nfet_01v8 L=0.15 W=0.91 nf=1 ad='int((nf+1)/2) * W/nf * 0.29' as='int((nf+2)/2) * W/nf * 0.29'
+ pd='2*int((nf+1)/2) * (W/nf + 0.29)' ps='2*int((nf+2)/2) * (W/nf + 0.29)' nrd='0.29 / W' nrs='0.29 / W'
+ sa=0 sb=0 sd=0 mult=8 m=8
XM2 net1 Clk VDD VDD sky130_fd_pr__pfet_01v8 L=0.15 W=1.605 nf=1 ad='int((nf+1)/2) * W/nf * 0.29' as='int((nf+2)/2) * W/nf * 0.29'
+ pd='2*int((nf+1)/2) * (W/nf + 0.29)' ps='2*int((nf+2)/2) * (W/nf + 0.29)' nrd='0.29 / W' nrs='0.29 / W'
+ sa=0 sb=0 sd=0 mult=1 m=1
XM3 net1 Clk net3 VSS sky130_fd_pr__nfet_01v8 L=0.15 W=0.91 nf=1 ad='int((nf+1)/2) * W/nf * 0.29' as='int((nf+2)/2) * W/nf * 0.29'
+ pd='2*int((nf+1)/2) * (W/nf + 0.29)' ps='2*int((nf+2)/2) * (W/nf + 0.29)' nrd='0.29 / W' nrs='0.29 / W'
+ sa=0 sb=0 sd=0 mult=1 m=1
XC1 net2 net3 sky130_fd_pr__cap_mim_m3_1 W=50 L=50 MF=1 m=1
XM4 net2 net4 VDD net2 sky130_fd_pr__pfet_01v8 L=0.15 W=0.91 nf=1 ad='int((nf+1)/2) * W/nf * 0.29' as='int((nf+2)/2) * W/nf * 0.29'
+ pd='2*int((nf+1)/2) * (W/nf + 0.29)' ps='2*int((nf+2)/2) * (W/nf + 0.29)' nrd='0.29 / W' nrs='0.29 / W'
+ sa=0 sb=0 sd=0 mult=1 m=1
XM5 net4 net1 net2 net2 sky130_fd_pr__pfet_01v8 L=0.15 W=1.605 nf=1 ad='int((nf+1)/2) * W/nf * 0.29'
+ as='int((nf+2)/2) * W/nf * 0.29' pd='2*int((nf+1)/2) * (W/nf + 0.29)' ps='2*int((nf+2)/2) * (W/nf + 0.29)'
+ nrd='0.29 / W' nrs='0.29 / W' sa=0 sb=0 sd=0 mult=1 m=1
XM6 net1 net4 net3 VSS sky130_fd_pr__nfet_01v8 L=0.15 W=0.91 nf=1 ad='int((nf+1)/2) * W/nf * 0.29' as='int((nf+2)/2) * W/nf * 0.29'
+ pd='2*int((nf+1)/2) * (W/nf + 0.29)' ps='2*int((nf+2)/2) * (W/nf + 0.29)' nrd='0.29 / W' nrs='0.29 / W'
+ sa=0 sb=0 sd=0 mult=1 m=1
XM7 Vin_p net4 net3 VSS sky130_fd_pr__nfet_01v8 L=0.15 W=0.91 nf=1 ad='int((nf+1)/2) * W/nf * 0.29' as='int((nf+2)/2) * W/nf * 0.29'
+ pd='2*int((nf+1)/2) * (W/nf + 0.29)' ps='2*int((nf+2)/2) * (W/nf + 0.29)' nrd='0.29 / W' nrs='0.29 / W'
+ sa=0 sb=0 sd=0 mult=1 m=1
XM8 Vin_p net4 Vout_p VSS sky130_fd_pr__nfet_01v8 L=0.15 W=0.91 nf=1 ad='int((nf+1)/2) * W/nf * 0.29'
+ as='int((nf+2)/2) * W/nf * 0.29' pd='2*int((nf+1)/2) * (W/nf + 0.29)' ps='2*int((nf+2)/2) * (W/nf + 0.29)'
+ nrd='0.29 / W' nrs='0.29 / W' sa=0 sb=0 sd=0 mult=75 m=75
XM9 net4 VDD net5 VSS sky130_fd_pr__nfet_01v8 L=0.15 W=0.91 nf=1 ad='int((nf+1)/2) * W/nf * 0.29' as='int((nf+2)/2) * W/nf * 0.29'
+ pd='2*int((nf+1)/2) * (W/nf + 0.29)' ps='2*int((nf+2)/2) * (W/nf + 0.29)' nrd='0.29 / W' nrs='0.29 / W'
+ sa=0 sb=0 sd=0 mult=2 m=2
XM10 net5 Clk_n VSS VSS sky130_fd_pr__nfet_01v8 L=0.15 W=0.91 nf=1 ad='int((nf+1)/2) * W/nf * 0.29' as='int((nf+2)/2) * W/nf * 0.29'
+ pd='2*int((nf+1)/2) * (W/nf + 0.29)' ps='2*int((nf+2)/2) * (W/nf + 0.29)' nrd='0.29 / W' nrs='0.29 / W'
+ sa=0 sb=0 sd=0 mult=1 m=1
x1 Clk VSS VSS VDD VDD Clk_n sky130_fd_sc_hd__clkinv_1
XM11 net8 Clk_n VSS VSS sky130_fd_pr__nfet_01v8 L=0.15 W=0.91 nf=1 ad='int((nf+1)/2) * W/nf * 0.29' as='int((nf+2)/2) * W/nf * 0.29'
+ pd='2*int((nf+1)/2) * (W/nf + 0.29)' ps='2*int((nf+2)/2) * (W/nf + 0.29)' nrd='0.29 / W' nrs='0.29 / W'
+ sa=0 sb=0 sd=0 mult=8 m=8
XM12 net6 Clk VDD VDD sky130_fd_pr__pfet_01v8 L=0.15 W=1.605 nf=1 ad='int((nf+1)/2) * W/nf * 0.29' as='int((nf+2)/2) * W/nf * 0.29'
+ pd='2*int((nf+1)/2) * (W/nf + 0.29)' ps='2*int((nf+2)/2) * (W/nf + 0.29)' nrd='0.29 / W' nrs='0.29 / W'
+ sa=0 sb=0 sd=0 mult=1 m=1
XM13 net6 Clk net8 VSS sky130_fd_pr__nfet_01v8 L=0.15 W=0.91 nf=1 ad='int((nf+1)/2) * W/nf * 0.29' as='int((nf+2)/2) * W/nf * 0.29'
+ pd='2*int((nf+1)/2) * (W/nf + 0.29)' ps='2*int((nf+2)/2) * (W/nf + 0.29)' nrd='0.29 / W' nrs='0.29 / W'
+ sa=0 sb=0 sd=0 mult=1 m=1
XC2 net7 net8 sky130_fd_pr__cap_mim_m3_1 W=50 L=50 MF=1 m=1
XM14 net7 net9 VDD net7 sky130_fd_pr__pfet_01v8 L=0.15 W=0.91 nf=1 ad='int((nf+1)/2) * W/nf * 0.29' as='int((nf+2)/2) * W/nf * 0.29'
+ pd='2*int((nf+1)/2) * (W/nf + 0.29)' ps='2*int((nf+2)/2) * (W/nf + 0.29)' nrd='0.29 / W' nrs='0.29 / W'
+ sa=0 sb=0 sd=0 mult=1 m=1
XM15 net9 net6 net7 net7 sky130_fd_pr__pfet_01v8 L=0.15 W=1.605 nf=1 ad='int((nf+1)/2) * W/nf * 0.29'
+ as='int((nf+2)/2) * W/nf * 0.29' pd='2*int((nf+1)/2) * (W/nf + 0.29)' ps='2*int((nf+2)/2) * (W/nf + 0.29)'
+ nrd='0.29 / W' nrs='0.29 / W' sa=0 sb=0 sd=0 mult=1 m=1
XM16 net6 net9 net8 VSS sky130_fd_pr__nfet_01v8 L=0.15 W=0.91 nf=1 ad='int((nf+1)/2) * W/nf * 0.29' as='int((nf+2)/2) * W/nf * 0.29'
+ pd='2*int((nf+1)/2) * (W/nf + 0.29)' ps='2*int((nf+2)/2) * (W/nf + 0.29)' nrd='0.29 / W' nrs='0.29 / W'
+ sa=0 sb=0 sd=0 mult=1 m=1
XM17 Vin_n net9 net8 VSS sky130_fd_pr__nfet_01v8 L=0.15 W=0.91 nf=1 ad='int((nf+1)/2) * W/nf * 0.29'
+ as='int((nf+2)/2) * W/nf * 0.29' pd='2*int((nf+1)/2) * (W/nf + 0.29)' ps='2*int((nf+2)/2) * (W/nf + 0.29)'
+ nrd='0.29 / W' nrs='0.29 / W' sa=0 sb=0 sd=0 mult=1 m=1
XM18 Vin_n net9 Vout_n VSS sky130_fd_pr__nfet_01v8 L=0.15 W=0.91 nf=1 ad='int((nf+1)/2) * W/nf * 0.29'
+ as='int((nf+2)/2) * W/nf * 0.29' pd='2*int((nf+1)/2) * (W/nf + 0.29)' ps='2*int((nf+2)/2) * (W/nf + 0.29)'
+ nrd='0.29 / W' nrs='0.29 / W' sa=0 sb=0 sd=0 mult=75 m=75
XM19 net9 VDD net10 VSS sky130_fd_pr__nfet_01v8 L=0.15 W=0.91 nf=1 ad='int((nf+1)/2) * W/nf * 0.29' as='int((nf+2)/2) * W/nf * 0.29'
+ pd='2*int((nf+1)/2) * (W/nf + 0.29)' ps='2*int((nf+2)/2) * (W/nf + 0.29)' nrd='0.29 / W' nrs='0.29 / W'
+ sa=0 sb=0 sd=0 mult=2 m=2
XM20 net10 Clk_n VSS VSS sky130_fd_pr__nfet_01v8 L=0.15 W=0.91 nf=1 ad='int((nf+1)/2) * W/nf * 0.29'
+ as='int((nf+2)/2) * W/nf * 0.29' pd='2*int((nf+1)/2) * (W/nf + 0.29)' ps='2*int((nf+2)/2) * (W/nf + 0.29)'
+ nrd='0.29 / W' nrs='0.29 / W' sa=0 sb=0 sd=0 mult=1 m=1
.ends


* expanding   symbol:  src/xor_clock_gen/xor_clock_gen.sym # of pins=8
** sym_path: /foss/designs/sky130-10-bit-SAR-ADC/xschem/src/xor_clock_gen/xor_clock_gen.sym
** sch_path: /foss/designs/sky130-10-bit-SAR-ADC/xschem/src/xor_clock_gen/xor_clock_gen.sch
.subckt xor_clock_gen  VSS Vin_p VDD Vin_n Gen_clk Clk Vin_q Reset
*.ipin Vin_p
*.iopin VSS
*.opin Gen_clk
*.iopin VDD
*.ipin Vin_n
*.ipin Clk
*.ipin Reset
*.opin Vin_q
x1 Vin_p Vin_n VSS VSS VDD VDD net2 sky130_fd_sc_hd__xor2_1
x14 net2 Vin_p Reset VSS VSS VDD VDD net1 sky130_fd_sc_hd__dfrtp_1
x19 net10 VSS VSS VDD VDD Vin_q sky130_fd_sc_hd__buf_16
x2 net2 VSS VSS VDD VDD net16 sky130_fd_sc_hd__clkdlybuf4s50_1
x3 net3 VSS VSS VDD VDD net4 sky130_fd_sc_hd__clkdlybuf4s50_1
x4 net4 VSS VSS VDD VDD net5 sky130_fd_sc_hd__clkdlybuf4s50_1
x5 net5 VSS VSS VDD VDD net6 sky130_fd_sc_hd__clkdlybuf4s50_1
x6 net6 VSS VSS VDD VDD net7 sky130_fd_sc_hd__clkdlybuf4s50_1
x7 net7 VSS VSS VDD VDD net15 sky130_fd_sc_hd__clkdlybuf4s50_1
x8 net8 VSS VSS VDD VDD Gen_clk sky130_fd_sc_hd__buf_16
x9 net1 VSS VSS VDD VDD net9 sky130_fd_sc_hd__buf_4
x10 net9 VSS VSS VDD VDD net10 sky130_fd_sc_hd__buf_8
x11 net12 VSS VSS VDD VDD net11 sky130_fd_sc_hd__buf_4
x12 net11 VSS VSS VDD VDD net8 sky130_fd_sc_hd__buf_8
XC1 net12 VSS sky130_fd_pr__cap_mim_m3_1 W=25 L=25 MF=1 m=1
x13 net15 VSS VSS VDD VDD net13 sky130_fd_sc_hd__clkdlybuf4s50_1
x15 net13 VSS VSS VDD VDD net14 sky130_fd_sc_hd__clkdlybuf4s50_1
x16 net14 VSS VSS VDD VDD net12 sky130_fd_sc_hd__clkdlybuf4s50_1
x17 net16 VSS VSS VDD VDD net17 sky130_fd_sc_hd__clkdlybuf4s50_1
x18 net17 VSS VSS VDD VDD net18 sky130_fd_sc_hd__clkdlybuf4s50_1
x20 net18 VSS VSS VDD VDD net19 sky130_fd_sc_hd__clkdlybuf4s50_1
x21 net19 VSS VSS VDD VDD net20 sky130_fd_sc_hd__clkdlybuf4s50_1
x22 net20 VSS VSS VDD VDD net23 sky130_fd_sc_hd__clkdlybuf4s50_1
x23 net23 VSS VSS VDD VDD net21 sky130_fd_sc_hd__clkdlybuf4s50_1
x24 net21 VSS VSS VDD VDD net22 sky130_fd_sc_hd__clkdlybuf4s50_1
x25 net22 VSS VSS VDD VDD net3 sky130_fd_sc_hd__clkdlybuf4s50_1
.ends


* expanding   symbol:  src/dec/dec.sym # of pins=7
** sym_path: /foss/designs/sky130-10-bit-SAR-ADC/xschem/src/dec/dec.sym
** sch_path: /foss/designs/sky130-10-bit-SAR-ADC/xschem/src/dec/dec.sch
.subckt dec  VDD raw_bit13 raw_bit12 raw_bit11 raw_bit10 raw_bit9 raw_bit8 raw_bit7 raw_bit6
+ raw_bit5 raw_bit4 raw_bit3 raw_bit2 raw_bit1 VSS reset_b bit10 bit9 bit8 bit7 bit6 bit5 bit4 bit3 bit2 bit1
+ done dump_bus
*.iopin VDD
*.opin bit10,bit9,bit8,bit7,bit6,bit5,bit4,bit3,bit2,bit1
*.iopin VSS
*.ipin reset_b
*.ipin dump_bus
*.opin done
*.ipin
*+ raw_bit13,raw_bit12,raw_bit11,raw_bit10,raw_bit9,raw_bit8,raw_bit7,raw_bit6,raw_bit5,raw_bit4,raw_bit3,raw_bit2,raw_bit1
x62 raw_bit2 raw_bit1 net1 VSS VSS VDD VDD net16 net2 sky130_fd_sc_hd__fa_1
x64 raw_bit3 raw_bit1 net4 VSS VSS VDD VDD net1 net3 sky130_fd_sc_hd__fa_1
x67 dump_bus net2 reset_b VSS VSS VDD VDD bit2 sky130_fd_sc_hd__dfrtp_1
x68 dump_bus net3 reset_b VSS VSS VDD VDD bit3 sky130_fd_sc_hd__dfrtp_1
x65 raw_bit5 raw_bit4 net5 VSS VSS VDD VDD net4 net6 sky130_fd_sc_hd__fa_1
x69 raw_bit6 raw_bit4 net8 VSS VSS VDD VDD net5 net7 sky130_fd_sc_hd__fa_1
x70 dump_bus net6 reset_b VSS VSS VDD VDD bit4 sky130_fd_sc_hd__dfrtp_1
x71 dump_bus net7 reset_b VSS VSS VDD VDD bit5 sky130_fd_sc_hd__dfrtp_1
x72 raw_bit7 raw_bit4 net9 VSS VSS VDD VDD net8 net10 sky130_fd_sc_hd__fa_1
x73 raw_bit9 raw_bit8 net12 VSS VSS VDD VDD net9 net11 sky130_fd_sc_hd__fa_1
x74 dump_bus net10 reset_b VSS VSS VDD VDD bit6 sky130_fd_sc_hd__dfrtp_1
x75 dump_bus net11 reset_b VSS VSS VDD VDD bit7 sky130_fd_sc_hd__dfrtp_1
x76 raw_bit10 raw_bit8 net13 VSS VSS VDD VDD net12 net14 sky130_fd_sc_hd__fa_1
x77 raw_bit11 raw_bit8 raw_bit12 VSS VSS VDD VDD net13 net15 sky130_fd_sc_hd__fa_1
x78 dump_bus net14 reset_b VSS VSS VDD VDD bit8 sky130_fd_sc_hd__dfrtp_1
x79 dump_bus net15 reset_b VSS VSS VDD VDD bit9 sky130_fd_sc_hd__dfrtp_1
x80 dump_bus net16 reset_b VSS VSS VDD VDD bit1 sky130_fd_sc_hd__dfrtp_1
x81 dump_bus raw_bit13 reset_b VSS VSS VDD VDD bit10 sky130_fd_sc_hd__dfrtp_1
x82 dump_bus VSS VSS VDD VDD done sky130_fd_sc_hd__inv_1
.ends
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
