UAH-IC-Design-Team/sky130-10-bit-SAR-ADC/util/xspice_sc_lib.spice

* XSpice library created from liberty sources by spi2xspice.py

.model todig_1v8 adc_bridge(in_high=1.2 in_low=0.6 rise_delay=10n fall_delay=10n)
.model toana_1v8 dac_bridge(out_high=1.8 out_low=0)

.model ddflop d_dff(ic=0 rise_delay=1n fall_delay=1n)
.model dzero d_pulldown(load=1p)
.model done d_pullup(load=1p)

* sky130_fd_sc_hd__a2111o_1 (A1&A2) | (B1) | (C1) | (D1)
.model d_lut_sky130_fd_sc_hd__a2111o_1 d_lut (rise_delay=1n fall_delay=1n input_load=1p
+ table_values "00011111111111111111111111111111")
* sky130_fd_sc_hd__a2111o_2 (A1&A2) | (B1) | (C1) | (D1)
.model d_lut_sky130_fd_sc_hd__a2111o_2 d_lut (rise_delay=1n fall_delay=1n input_load=1p
+ table_values "00011111111111111111111111111111")
* sky130_fd_sc_hd__a2111o_4 (A1&A2) | (B1) | (C1) | (D1)
.model d_lut_sky130_fd_sc_hd__a2111o_4 d_lut (rise_delay=1n fall_delay=1n input_load=1p
+ table_values "00011111111111111111111111111111")
* sky130_fd_sc_hd__a2111oi_0 (!A1&!B1&!C1&!D1) | (!A2&!B1&!C1&!D1)
.model d_lut_sky130_fd_sc_hd__a2111oi_0 d_lut (rise_delay=1n fall_delay=1n input_load=1p
+ table_values "11100000000000000000000000000000")
* sky130_fd_sc_hd__a2111oi_1 (!A1&!B1&!C1&!D1) | (!A2&!B1&!C1&!D1)
.model d_lut_sky130_fd_sc_hd__a2111oi_1 d_lut (rise_delay=1n fall_delay=1n input_load=1p
+ table_values "11100000000000000000000000000000")
* sky130_fd_sc_hd__a2111oi_2 (!A1&!B1&!C1&!D1) | (!A2&!B1&!C1&!D1)
.model d_lut_sky130_fd_sc_hd__a2111oi_2 d_lut (rise_delay=1n fall_delay=1n input_load=1p
+ table_values "11100000000000000000000000000000")
* sky130_fd_sc_hd__a2111oi_4 (!A1&!B1&!C1&!D1) | (!A2&!B1&!C1&!D1)
.model d_lut_sky130_fd_sc_hd__a2111oi_4 d_lut (rise_delay=1n fall_delay=1n input_load=1p
+ table_values "11100000000000000000000000000000")
* sky130_fd_sc_hd__a211o_1 (A1&A2) | (B1) | (C1)
.model d_lut_sky130_fd_sc_hd__a211o_1 d_lut (rise_delay=1n fall_delay=1n input_load=1p
+ table_values "0001111111111111")
* sky130_fd_sc_hd__a211o_2 (A1&A2) | (B1) | (C1)
.model d_lut_sky130_fd_sc_hd__a211o_2 d_lut (rise_delay=1n fall_delay=1n input_load=1p
+ table_values "0001111111111111")
* sky130_fd_sc_hd__a211o_4 (A1&A2) | (B1) | (C1)
.model d_lut_sky130_fd_sc_hd__a211o_4 d_lut (rise_delay=1n fall_delay=1n input_load=1p
+ table_values "0001111111111111")
* sky130_fd_sc_hd__a211oi_1 (!A1&!B1&!C1) | (!A2&!B1&!C1)
.model d_lut_sky130_fd_sc_hd__a211oi_1 d_lut (rise_delay=1n fall_delay=1n input_load=1p
+ table_values "1110000000000000")
* sky130_fd_sc_hd__a211oi_2 (!A1&!B1&!C1) | (!A2&!B1&!C1)
.model d_lut_sky130_fd_sc_hd__a211oi_2 d_lut (rise_delay=1n fall_delay=1n input_load=1p
+ table_values "1110000000000000")
* sky130_fd_sc_hd__a211oi_4 (!A1&!B1&!C1) | (!A2&!B1&!C1)
.model d_lut_sky130_fd_sc_hd__a211oi_4 d_lut (rise_delay=1n fall_delay=1n input_load=1p
+ table_values "1110000000000000")
* sky130_fd_sc_hd__a21bo_1 (A1&A2) | (!B1_N)
.model d_lut_sky130_fd_sc_hd__a21bo_1 d_lut (rise_delay=1n fall_delay=1n input_load=1p
+ table_values "11110001")
* sky130_fd_sc_hd__a21bo_2 (A1&A2) | (!B1_N)
.model d_lut_sky130_fd_sc_hd__a21bo_2 d_lut (rise_delay=1n fall_delay=1n input_load=1p
+ table_values "11110001")
* sky130_fd_sc_hd__a21bo_4 (A1&A2) | (!B1_N)
.model d_lut_sky130_fd_sc_hd__a21bo_4 d_lut (rise_delay=1n fall_delay=1n input_load=1p
+ table_values "11110001")
* sky130_fd_sc_hd__a21boi_0 (!A1&B1_N) | (!A2&B1_N)
.model d_lut_sky130_fd_sc_hd__a21boi_0 d_lut (rise_delay=1n fall_delay=1n input_load=1p
+ table_values "00001110")
* sky130_fd_sc_hd__a21boi_1 (!A1&B1_N) | (!A2&B1_N)
.model d_lut_sky130_fd_sc_hd__a21boi_1 d_lut (rise_delay=1n fall_delay=1n input_load=1p
+ table_values "00001110")
* sky130_fd_sc_hd__a21boi_2 (!A1&B1_N) | (!A2&B1_N)
.model d_lut_sky130_fd_sc_hd__a21boi_2 d_lut (rise_delay=1n fall_delay=1n input_load=1p
+ table_values "00001110")
* sky130_fd_sc_hd__a21boi_4 (!A1&B1_N) | (!A2&B1_N)
.model d_lut_sky130_fd_sc_hd__a21boi_4 d_lut (rise_delay=1n fall_delay=1n input_load=1p
+ table_values "00001110")
* sky130_fd_sc_hd__a21o_1 (A1&A2) | (B1)
.model d_lut_sky130_fd_sc_hd__a21o_1 d_lut (rise_delay=1n fall_delay=1n input_load=1p
+ table_values "00011111")
* sky130_fd_sc_hd__a21o_2 (A1&A2) | (B1)
.model d_lut_sky130_fd_sc_hd__a21o_2 d_lut (rise_delay=1n fall_delay=1n input_load=1p
+ table_values "00011111")
* sky130_fd_sc_hd__a21o_4 (A1&A2) | (B1)
.model d_lut_sky130_fd_sc_hd__a21o_4 d_lut (rise_delay=1n fall_delay=1n input_load=1p
+ table_values "00011111")
* sky130_fd_sc_hd__a21oi_1 (!A1&!B1) | (!A2&!B1)
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
.model d_lut_sky130_fd_sc_hd__clkinv_16 d_lut (rise_delay=1n fall_delay=1n input_load=1p
+ table_values "10")
* sky130_fd_sc_hd__clkinv_2 (!A)
.model d_lut_sky130_fd_sc_hd__clkinv_2 d_lut (rise_delay=1n fall_delay=1n input_load=1p
+ table_values "10")
* sky130_fd_sc_hd__clkinv_4 (!A)
.model d_lut_sky130_fd_sc_hd__clkinv_4 d_lut (rise_delay=1n fall_delay=1n input_load=1p
+ table_values "10")
* sky130_fd_sc_hd__clkinv_8 (!A)
.model d_lut_sky130_fd_sc_hd__clkinv_8 d_lut (rise_delay=1n fall_delay=1n input_load=1p
+ table_values "10")
* sky130_fd_sc_hd__clkinvlp_2 (!A)
.model d_lut_sky130_fd_sc_hd__clkinvlp_2 d_lut (rise_delay=1n fall_delay=1n input_load=1p
+ table_values "10")
* sky130_fd_sc_hd__clkinvlp_4 (!A)
.model d_lut_sky130_fd_sc_hd__clkinvlp_4 d_lut (rise_delay=1n fall_delay=1n input_load=1p
+ table_values "10")
* sky130_fd_sc_hd__conb_1 1
* sky130_fd_sc_hd__decap_12 (no function)
* sky130_fd_sc_hd__decap_3 (no function)
* sky130_fd_sc_hd__decap_4 (no function)
* sky130_fd_sc_hd__decap_6 (no function)
* sky130_fd_sc_hd__decap_8 (no function)
* sky130_fd_sc_hd__dfbbn_1 IQ
* sky130_fd_sc_hd__dfbbn_2 IQ
* sky130_fd_sc_hd__dfbbp_1 IQ
* sky130_fd_sc_hd__dfrbp_1 IQ
* sky130_fd_sc_hd__dfrbp_2 IQ
* sky130_fd_sc_hd__dfrtn_1 IQ
* sky130_fd_sc_hd__dfrtp_1 IQ
* sky130_fd_sc_hd__dfrtp_2 IQ
* sky130_fd_sc_hd__dfrtp_4 IQ
* sky130_fd_sc_hd__dfsbp_1 IQ
* sky130_fd_sc_hd__dfsbp_2 IQ
* sky130_fd_sc_hd__dfstp_1 IQ
* sky130_fd_sc_hd__dfstp_2 IQ
* sky130_fd_sc_hd__dfstp_4 IQ
* sky130_fd_sc_hd__dfxbp_1 IQ
* sky130_fd_sc_hd__dfxbp_2 IQ
* sky130_fd_sc_hd__dfxtp_1 IQ
* sky130_fd_sc_hd__dfxtp_2 IQ
* sky130_fd_sc_hd__dfxtp_4 IQ
* sky130_fd_sc_hd__diode_2 (no function)
* sky130_fd_sc_hd__dlclkp_1 (no function)
* sky130_fd_sc_hd__dlclkp_2 (no function)
* sky130_fd_sc_hd__dlclkp_4 (no function)
* sky130_fd_sc_hd__dlrbn_1 IQ
* sky130_fd_sc_hd__dlrbn_2 IQ
* sky130_fd_sc_hd__dlrbp_1 IQ
* sky130_fd_sc_hd__dlrbp_2 IQ
* sky130_fd_sc_hd__dlrtn_1 IQ
* sky130_fd_sc_hd__dlrtn_2 IQ
* sky130_fd_sc_hd__dlrtn_4 IQ
* sky130_fd_sc_hd__dlrtp_1 IQ
* sky130_fd_sc_hd__dlrtp_2 IQ
* sky130_fd_sc_hd__dlrtp_4 IQ
* sky130_fd_sc_hd__dlxbn_1 IQ
* sky130_fd_sc_hd__dlxbn_2 IQ
* sky130_fd_sc_hd__dlxbp_1 IQ
* sky130_fd_sc_hd__dlxtn_1 IQ
* sky130_fd_sc_hd__dlxtn_2 IQ
* sky130_fd_sc_hd__dlxtn_4 IQ
* sky130_fd_sc_hd__dlxtp_1 IQ
* sky130_fd_sc_hd__dlygate4sd1_1 (A)
.model d_lut_sky130_fd_sc_hd__dlygate4sd1_1 d_lut (rise_delay=1n fall_delay=1n input_load=1p
+ table_values "01")
* sky130_fd_sc_hd__dlygate4sd2_1 (A)
.model d_lut_sky130_fd_sc_hd__dlygate4sd2_1 d_lut (rise_delay=1n fall_delay=1n input_load=1p
+ table_values "01")
* sky130_fd_sc_hd__dlygate4sd3_1 (A)
.model d_lut_sky130_fd_sc_hd__dlygate4sd3_1 d_lut (rise_delay=1n fall_delay=1n input_load=1p
+ table_values "01")
* sky130_fd_sc_hd__dlymetal6s2s_1 (A)
.model d_lut_sky130_fd_sc_hd__dlymetal6s2s_1 d_lut (rise_delay=1n fall_delay=1n input_load=1p
+ table_values "01")
* sky130_fd_sc_hd__dlymetal6s4s_1 (A)
.model d_lut_sky130_fd_sc_hd__dlymetal6s4s_1 d_lut (rise_delay=1n fall_delay=1n input_load=1p
+ table_values "01")
* sky130_fd_sc_hd__dlymetal6s6s_1 (A)
.model d_lut_sky130_fd_sc_hd__dlymetal6s6s_1 d_lut (rise_delay=1n fall_delay=1n input_load=1p
+ table_values "01")
* sky130_fd_sc_hd__ebufn_1 (A)
.model d_lut_sky130_fd_sc_hd__ebufn_1 d_lut (rise_delay=1n fall_delay=1n input_load=1p
+ table_values "0Z0Z")
* sky130_fd_sc_hd__ebufn_2 (A)
.model d_lut_sky130_fd_sc_hd__ebufn_2 d_lut (rise_delay=1n fall_delay=1n input_load=1p
+ table_values "0Z0Z")
* sky130_fd_sc_hd__ebufn_4 (A)
.model d_lut_sky130_fd_sc_hd__ebufn_4 d_lut (rise_delay=1n fall_delay=1n input_load=1p
+ table_values "0Z0Z")
* sky130_fd_sc_hd__ebufn_8 (A)
.model d_lut_sky130_fd_sc_hd__ebufn_8 d_lut (rise_delay=1n fall_delay=1n input_load=1p
+ table_values "0Z0Z")
* sky130_fd_sc_hd__edfxbp_1 IQ
* sky130_fd_sc_hd__edfxtp_1 IQ
* sky130_fd_sc_hd__einvn_0 (!A)
.model d_lut_sky130_fd_sc_hd__einvn_0 d_lut (rise_delay=1n fall_delay=1n input_load=1p
+ table_values "1Z1Z")
* sky130_fd_sc_hd__einvn_1 (!A)
.model d_lut_sky130_fd_sc_hd__einvn_1 d_lut (rise_delay=1n fall_delay=1n input_load=1p
+ table_values "1Z1Z")
* sky130_fd_sc_hd__einvn_2 (!A)
.model d_lut_sky130_fd_sc_hd__einvn_2 d_lut (rise_delay=1n fall_delay=1n input_load=1p
+ table_values "1Z1Z")
* sky130_fd_sc_hd__einvn_4 (!A)
.model d_lut_sky130_fd_sc_hd__einvn_4 d_lut (rise_delay=1n fall_delay=1n input_load=1p
+ table_values "1Z1Z")
* sky130_fd_sc_hd__einvn_8 (!A)
.model d_lut_sky130_fd_sc_hd__einvn_8 d_lut (rise_delay=1n fall_delay=1n input_load=1p
+ table_values "1Z1Z")
* sky130_fd_sc_hd__einvp_1 (!A)
.model d_lut_sky130_fd_sc_hd__einvp_1 d_lut (rise_delay=1n fall_delay=1n input_load=1p
+ table_values "Z0Z0")
* sky130_fd_sc_hd__einvp_2 (!A)
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
+ table_values "01")
* sky130_fd_sc_hd__lpflow_clkinvkapwr_1 (!A)
.model d_lut_sky130_fd_sc_hd__lpflow_clkinvkapwr_1 d_lut (rise_delay=1n fall_delay=1n input_load=1p
+ table_values "10")
* sky130_fd_sc_hd__lpflow_clkinvkapwr_16 (!A)
.model d_lut_sky130_fd_sc_hd__lpflow_clkinvkapwr_16 d_lut (rise_delay=1n fall_delay=1n input_load=1p
+ table_values "10")
* sky130_fd_sc_hd__lpflow_clkinvkapwr_2 (!A)
.model d_lut_sky130_fd_sc_hd__lpflow_clkinvkapwr_2 d_lut (rise_delay=1n fall_delay=1n input_load=1p
+ table_values "10")
* sky130_fd_sc_hd__lpflow_clkinvkapwr_4 (!A)
.model d_lut_sky130_fd_sc_hd__lpflow_clkinvkapwr_4 d_lut (rise_delay=1n fall_delay=1n input_load=1p
+ table_values "10")
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
