UAH-IC-Design-Team/sky130-10-bit-SAR-ADC/xschem/src/capacitor_array/capacitor_array.spice

** sch_path: /foss/designs/sky130-10-bit-SAR-ADC/xschem/src/capacitor_array/capacitor_array.sch
.subckt capacitor_array sw_sp_n9 sw_sp_n8 sw_sp_n7 sw_sp_n6 sw_sp_n5 sw_sp_n4 sw_sp_n3 sw_sp_n2
+ sw_sp_n1 Vin_p Vin_n sw_sp_p9 sw_sp_p8 sw_sp_p7 sw_sp_p6 sw_sp_p5 sw_sp_p4 sw_sp_p3 sw_sp_p2 sw_sp_p1 sw_p8
+ sw_p7 sw_p6 sw_p5 sw_p4 sw_p3 sw_p2 sw_p1 sw_n8 sw_n7 sw_n6 sw_n5 sw_n4 sw_n3 sw_n2 sw_n1
*.PININFO sw_sp_n[9..1]:I Vin_p:B Vin_n:B sw_sp_p[9..1]:I sw_p[8..1]:I sw_n[8..1]:I
XC1 sw_sp_n1 Vin_n sky130_fd_pr__cap_mim_m3_1 W=unit_cap_w L=unit_cap_l MF=128 m=128
XC2 sw_sp_n2 Vin_n sky130_fd_pr__cap_mim_m3_1 W=unit_cap_w L=unit_cap_l MF=64 m=64
XC3 sw_n1 Vin_n sky130_fd_pr__cap_mim_m3_1 W=unit_cap_w L=unit_cap_l MF=128 m=128
XC4 sw_n2 Vin_n sky130_fd_pr__cap_mim_m3_1 W=unit_cap_w L=unit_cap_l MF=64 m=64
XC5 sw_sp_n3 Vin_n sky130_fd_pr__cap_mim_m3_1 W=unit_cap_w L=unit_cap_l MF=32 m=32
XC6 sw_sp_n4 Vin_n sky130_fd_pr__cap_mim_m3_1 W=unit_cap_w L=unit_cap_l MF=16 m=16
XC7 sw_sp_n5 Vin_n sky130_fd_pr__cap_mim_m3_1 W=unit_cap_w L=unit_cap_l MF=8 m=8
XC8 sw_n3 Vin_n sky130_fd_pr__cap_mim_m3_1 W=unit_cap_w L=unit_cap_l MF=32 m=32
XC9 sw_n4 Vin_n sky130_fd_pr__cap_mim_m3_1 W=unit_cap_w L=unit_cap_l MF=16 m=16
XC10 sw_n5 Vin_n sky130_fd_pr__cap_mim_m3_1 W=unit_cap_w L=unit_cap_l MF=8 m=8
XC11 sw_sp_n6 Vin_n sky130_fd_pr__cap_mim_m3_1 W=unit_cap_w L=unit_cap_l MF=4 m=4
XC12 sw_sp_n7 Vin_n sky130_fd_pr__cap_mim_m3_1 W=unit_cap_w L=unit_cap_l MF=2 m=2
XC13 sw_sp_n8 Vin_n sky130_fd_pr__cap_mim_m3_1 W=unit_cap_w L=unit_cap_l MF=1 m=1
XC14 sw_n6 Vin_n sky130_fd_pr__cap_mim_m3_1 W=unit_cap_w L=unit_cap_l MF=4 m=4
XC15 sw_n7 Vin_n sky130_fd_pr__cap_mim_m3_1 W=unit_cap_w L=unit_cap_l MF=2 m=2
XC16 sw_n8 Vin_n sky130_fd_pr__cap_mim_m3_1 W=unit_cap_w L=unit_cap_l MF=1 m=1
XC17 sw_sp_n9 Vin_n sky130_fd_pr__cap_mim_m3_1 W=unit_cap_w L=unit_cap_l MF=1 m=1
XC18 sw_sp_p1 Vin_p sky130_fd_pr__cap_mim_m3_1 W=unit_cap_w L=unit_cap_l MF=128 m=128
XC19 sw_sp_p2 Vin_p sky130_fd_pr__cap_mim_m3_1 W=unit_cap_w L=unit_cap_l MF=64 m=64
XC20 sw_p1 Vin_p sky130_fd_pr__cap_mim_m3_1 W=unit_cap_w L=unit_cap_l MF=128 m=128
XC21 sw_p2 Vin_p sky130_fd_pr__cap_mim_m3_1 W=unit_cap_w L=unit_cap_l MF=64 m=64
XC22 sw_sp_p3 Vin_p sky130_fd_pr__cap_mim_m3_1 W=unit_cap_w L=unit_cap_l MF=32 m=32
XC23 sw_sp_p4 Vin_p sky130_fd_pr__cap_mim_m3_1 W=unit_cap_w L=unit_cap_l MF=16 m=16
XC24 sw_sp_p5 Vin_p sky130_fd_pr__cap_mim_m3_1 W=unit_cap_w L=unit_cap_l MF=8 m=8
XC25 sw_p3 Vin_p sky130_fd_pr__cap_mim_m3_1 W=unit_cap_w L=unit_cap_l MF=32 m=32
XC26 sw_p4 Vin_p sky130_fd_pr__cap_mim_m3_1 W=unit_cap_w L=unit_cap_l MF=16 m=16
XC27 sw_p5 Vin_p sky130_fd_pr__cap_mim_m3_1 W=unit_cap_w L=unit_cap_l MF=8 m=8
XC28 sw_sp_p6 Vin_p sky130_fd_pr__cap_mim_m3_1 W=unit_cap_w L=unit_cap_l MF=4 m=4
XC29 sw_sp_p7 Vin_p sky130_fd_pr__cap_mim_m3_1 W=unit_cap_w L=unit_cap_l MF=2 m=2
XC30 sw_sp_p8 Vin_p sky130_fd_pr__cap_mim_m3_1 W=unit_cap_w L=unit_cap_l MF=1 m=1
XC31 sw_p6 Vin_p sky130_fd_pr__cap_mim_m3_1 W=unit_cap_w L=unit_cap_l MF=4 m=4
XC32 sw_p7 Vin_p sky130_fd_pr__cap_mim_m3_1 W=unit_cap_w L=unit_cap_l MF=2 m=2
XC33 sw_p8 Vin_p sky130_fd_pr__cap_mim_m3_1 W=unit_cap_w L=unit_cap_l MF=1 m=1
XC34 sw_sp_p9 Vin_p sky130_fd_pr__cap_mim_m3_1 W=unit_cap_w L=unit_cap_l MF=1 m=1
.ends
.end
