UAH-IC-Design-Team/sky130-10-bit-SAR-ADC/xschem/src/controller/controller_xspice.spice

* XSpice netlist created from SPICE and liberty sources by spi2xspice.py
.subckt controller a_clk a_sw_n_sp9 a_sw_n_sp8 a_sw_n_sp7 a_sw_n_sp6 a_sw_n_sp5 a_sw_n_sp4 a_sw_n_sp3 a_sw_n_sp2 a_sw_n_sp1 a_VSS a_VDD a_reset a_Vcmp a_sw_n8 a_sw_n7 a_sw_n6 a_sw_n5 a_sw_n4 a_sw_n3 a_sw_n2 a_sw_n1 a_sw_p_sp9 a_sw_p_sp8 a_sw_p_sp7 a_sw_p_sp6 a_sw_p_sp5 a_sw_p_sp4 a_sw_p_sp3 a_sw_p_sp2 a_sw_p_sp1 a_sw_p8 a_sw_p7 a_sw_p6 a_sw_p5 a_sw_p4 a_sw_p3 a_sw_p2 a_sw_p1 a_bit10 a_bit9 a_bit8 a_bit7 a_bit6 a_bit5 a_bit4 a_bit3 a_bit2 a_bit1 a_done a_sw_sample
*.PININFO clk:I sw_n_sp_9..1_:O VSS:B VDD:B reset:I Vcmp:I sw_n_8..1_:O sw_p_sp_9..1_:O sw_p_8..1_:O
*+ bit_10..1_:O done:O sw_sample:O
A95 [cycle1 cycle2 cycle3 cycle4] net2 d_lut_sky130_fd_sc_hd__or4_2
A96 [cycle5 cycle6 cycle7 cycle8] net3 d_lut_sky130_fd_sc_hd__or4_2
A97 [cycle9 cycle10 cycle11 cycle12] net5 d_lut_sky130_fd_sc_hd__or4_2
A62_x3 [raw_bit2 raw_bit1 x3_net1] [x3_net16 x3_net2] d_genlut_sky130_fd_sc_hd__fa_1
A64_x3 [raw_bit3 raw_bit1 x3_net4] [x3_net1 x3_net3] d_genlut_sky130_fd_sc_hd__fa_1
A67_x3 x3_net2 cycle31 NULL ~reset NULL NULL ddflop
A68_x3 x3_net3 cycle31 NULL ~reset NULL NULL ddflop
A65_x3 [raw_bit5 raw_bit4 x3_net5] [x3_net4 x3_net6] d_genlut_sky130_fd_sc_hd__fa_1
A69_x3 [raw_bit6 raw_bit4 x3_net8] [x3_net5 x3_net7] d_genlut_sky130_fd_sc_hd__fa_1
A70_x3 x3_net6 cycle31 NULL ~reset NULL NULL ddflop
A71_x3 x3_net7 cycle31 NULL ~reset NULL NULL ddflop
A72_x3 [raw_bit7 raw_bit4 x3_net9] [x3_net8 x3_net10] d_genlut_sky130_fd_sc_hd__fa_1
A73_x3 [raw_bit9 raw_bit8 x3_net12] [x3_net9 x3_net11] d_genlut_sky130_fd_sc_hd__fa_1
A74_x3 x3_net10 cycle31 NULL ~reset NULL NULL ddflop
A75_x3 x3_net11 cycle31 NULL ~reset NULL NULL ddflop
A76_x3 [raw_bit10 raw_bit8 x3_net13] [x3_net12 x3_net14] d_genlut_sky130_fd_sc_hd__fa_1
A77_x3 [raw_bit11 raw_bit8 raw_bit12] [x3_net13 x3_net15] d_genlut_sky130_fd_sc_hd__fa_1
A78_x3 x3_net14 cycle31 NULL ~reset NULL NULL ddflop
A79_x3 x3_net15 cycle31 NULL ~reset NULL NULL ddflop
A80_x3 x3_net16 cycle31 NULL ~reset NULL NULL ddflop
A81_x3 raw_bit13 cycle31 NULL ~reset NULL NULL ddflop
A82_x3 [cycle31] done d_lut_sky130_fd_sc_hd__inv_1
A29_x4 [raw_bit1 vcmp] x4_net50 d_lut_sky130_fd_sc_hd__xor2_1
A31_x4 [raw_bit1 vcmp] x4_net51 d_lut_sky130_fd_sc_hd__xor2_1
A37_x4 [raw_bit4 vcmp] x4_net52 d_lut_sky130_fd_sc_hd__xor2_1
A40_x4 [raw_bit4 vcmp] x4_net53 d_lut_sky130_fd_sc_hd__xor2_1
A45_x4 [raw_bit4 vcmp] x4_net54 d_lut_sky130_fd_sc_hd__xor2_1
A100_x4 x4_net10 cycle18 NULL ~x4_net22 NULL NULL ddflop
A99_x4 [vcmp] x4_net10 d_lut_sky130_fd_sc_hd__inv_1
A102_x4 vcmp cycle18 NULL ~x4_net22 NULL NULL ddflop
A25_x4 vcmp cycle18 NULL ~x4_net24 NULL NULL ddflop
A103_x4 [vcmp] x4_net11 d_lut_sky130_fd_sc_hd__inv_1
A104_x4 x4_net11 cycle18 NULL ~x4_net24 NULL NULL ddflop
A21_x4 vcmp x4_net1 ~net1 NULL NULL NULL ddflop
A22_x4 x4_net12 x4_net1 ~net1 NULL NULL NULL ddflop
A105_x4 [vcmp] x4_net12 d_lut_sky130_fd_sc_hd__inv_1
A28_x4 vcmp x4_net3 ~net1 NULL NULL NULL ddflop
A106_x4 x4_net13 x4_net3 ~net1 NULL NULL NULL ddflop
A107_x4 [vcmp] x4_net13 d_lut_sky130_fd_sc_hd__inv_1
A109_x4 [vcmp] x4_net14 d_lut_sky130_fd_sc_hd__inv_1
A111_x4 [vcmp] x4_net15 d_lut_sky130_fd_sc_hd__inv_1
A27_x4 vcmp cycle21 NULL ~x4_net26 NULL NULL ddflop
A35_x4 x4_net14 cycle21 NULL ~x4_net26 NULL NULL ddflop
A41_x4 vcmp cycle21 NULL ~x4_net27 NULL NULL ddflop
A108_x4 x4_net15 cycle21 NULL ~x4_net27 NULL NULL ddflop
A110_x4 vcmp cycle21 NULL ~x4_net28 NULL NULL ddflop
A112_x4 x4_net16 cycle21 NULL ~x4_net28 NULL NULL ddflop
A113_x4 [vcmp] x4_net16 d_lut_sky130_fd_sc_hd__inv_1
A114_x4 x4_net17 x4_net5 ~net1 NULL NULL NULL ddflop
A32_x4 vcmp x4_net5 ~net1 NULL NULL NULL ddflop
A115_x4 [vcmp] x4_net17 d_lut_sky130_fd_sc_hd__inv_1
A38_x4 vcmp x4_net6 ~net1 NULL NULL NULL ddflop
A116_x4 x4_net18 x4_net6 ~net1 NULL NULL NULL ddflop
A117_x4 [vcmp] x4_net18 d_lut_sky130_fd_sc_hd__inv_1
A43_x4 vcmp x4_net7 ~net1 NULL NULL NULL ddflop
A118_x4 x4_net19 x4_net7 ~net1 NULL NULL NULL ddflop
A119_x4 [vcmp] x4_net19 d_lut_sky130_fd_sc_hd__inv_1
A132_x4 x4_net20 cycle29 NULL ~net1 NULL NULL ddflop
A133_x4 [vcmp] x4_net20 d_lut_sky130_fd_sc_hd__inv_1
A61_x4 vcmp cycle29 NULL ~net1 NULL NULL ddflop
A1_x4_x24 [x4_x24_net1 cycle19] x4_net1 d_lut_sky130_fd_sc_hd__and2_0
A2_x4_x24 [x4_net50 cycle19] x4_net2 d_lut_sky130_fd_sc_hd__and2_0
A3_x4_x24 [x4_net50] x4_x24_net1 d_lut_sky130_fd_sc_hd__inv_1
A1_x4_x30 [x4_x30_net1 cycle20] x4_net3 d_lut_sky130_fd_sc_hd__and2_0
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
A4_x1 cycle4 clk NULL ~x1_reset_b NULL NULL ddflop
A5_x1 cycle5 clk NULL ~x1_reset_b NULL NULL ddflop
A6_x1 cycle6 clk NULL ~x1_reset_b NULL NULL ddflop
A7_x1 cycle7 clk NULL ~x1_reset_b NULL NULL ddflop
A8_x1 cycle8 clk NULL ~x1_reset_b NULL NULL ddflop
A9_x1 cycle9 clk NULL ~x1_reset_b NULL NULL ddflop
A10_x1 cycle10 clk NULL ~x1_reset_b NULL NULL ddflop
A11_x1 cycle11 clk NULL ~x1_reset_b NULL NULL ddflop
A12_x1 cycle12 clk NULL ~x1_reset_b NULL NULL ddflop
A13_x1 cycle13 clk NULL ~x1_reset_b NULL NULL ddflop
A14_x1 cycle14 clk NULL ~x1_reset_b NULL NULL ddflop
A15_x1 cycle15 clk NULL ~x1_reset_b NULL NULL ddflop
A16_x1 cycle16 clk NULL ~x1_reset_b NULL NULL ddflop
A17_x1 cycle17 clk NULL ~x1_reset_b NULL NULL ddflop
A18_x1 cycle18 clk NULL ~x1_reset_b NULL NULL ddflop
A19_x1 cycle19 clk NULL ~x1_reset_b NULL NULL ddflop
A20_x1 cycle20 clk NULL ~x1_reset_b NULL NULL ddflop
A21_x1 cycle21 clk NULL ~x1_reset_b NULL NULL ddflop
A22_x1 cycle22 clk NULL ~x1_reset_b NULL NULL ddflop
A23_x1 cycle23 clk NULL ~x1_reset_b NULL NULL ddflop
A24_x1 cycle24 clk NULL ~x1_reset_b NULL NULL ddflop
A25_x1 cycle25 clk NULL ~x1_reset_b NULL NULL ddflop
A26_x1 cycle26 clk NULL ~x1_reset_b NULL NULL ddflop
A27_x1 cycle27 clk NULL ~x1_reset_b NULL NULL ddflop
A28_x1 cycle28 clk NULL ~x1_reset_b NULL NULL ddflop
A29_x1 cycle29 clk NULL ~x1_reset_b NULL NULL ddflop
A30_x1 cycle30 clk NULL ~x1_reset_b NULL NULL ddflop
A31_x1 vdd clk NULL ~x1_reset_b NULL NULL ddflop
A37_x1 [x1_net1] x1_reset_b d_lut_sky130_fd_sc_hd__buf_16
A35_x1 [x1_reset_cycle reset] x1_net1 d_lut_sky130_fd_sc_hd__and2_4
A33_x1 cycle31 ~clk NULL ~x1_reset_b NULL NULL ddflop
A38_x1 [x1_half_cycle cycle31] x1_reset_cycle d_lut_sky130_fd_sc_hd__nand2_1
A8 [net2 net3 net5 net4] net6 d_lut_sky130_fd_sc_hd__or4_2
A9 net6 ~clk NULL ~reset NULL NULL ddflop
A10 [cycle13 cycle14 cycle15] net4 d_lut_sky130_fd_sc_hd__or3_2
A6 [cycle0] net1 d_lut_sky130_fd_sc_hd__inv_16

.model todig_1v8 adc_bridge(in_high=1.2 in_low=0.6 rise_delay=10n fall_delay=10n)
.model toana_1v8 dac_bridge(out_high=1.8 out_low=0)

.model ddflop d_dff(ic=0 rise_delay=1n fall_delay=1n)
.model dzero d_pulldown(load=1p)
.model done d_pullup(load=1p)

AA2D1 [a_clk] [clk] todig_1v8
AA2D2 [a_sw_n_sp9] [sw_n_sp9] todig_1v8
AA2D3 [a_sw_n_sp8] [sw_n_sp8] todig_1v8
AA2D4 [a_sw_n_sp7] [sw_n_sp7] todig_1v8
AA2D5 [a_sw_n_sp6] [sw_n_sp6] todig_1v8
AA2D6 [a_sw_n_sp5] [sw_n_sp5] todig_1v8
AA2D7 [a_sw_n_sp4] [sw_n_sp4] todig_1v8
AA2D8 [a_sw_n_sp3] [sw_n_sp3] todig_1v8
AA2D9 [a_sw_n_sp2] [sw_n_sp2] todig_1v8
AA2D10 [a_sw_n_sp1] [sw_n_sp1] todig_1v8
AA2D11 [a_VSS] [VSS] todig_1v8
AA2D12 [a_VDD] [VDD] todig_1v8
AA2D13 [a_reset] [reset] todig_1v8
AA2D14 [a_Vcmp] [Vcmp] todig_1v8
AA2D15 [a_sw_n8] [sw_n8] todig_1v8
AA2D16 [a_sw_n7] [sw_n7] todig_1v8
AA2D17 [a_sw_n6] [sw_n6] todig_1v8
AA2D18 [a_sw_n5] [sw_n5] todig_1v8
AA2D19 [a_sw_n4] [sw_n4] todig_1v8
AA2D20 [a_sw_n3] [sw_n3] todig_1v8
AA2D21 [a_sw_n2] [sw_n2] todig_1v8
AA2D22 [a_sw_n1] [sw_n1] todig_1v8
AA2D23 [a_sw_p_sp9] [sw_p_sp9] todig_1v8
AA2D24 [a_sw_p_sp8] [sw_p_sp8] todig_1v8
AA2D25 [a_sw_p_sp7] [sw_p_sp7] todig_1v8
AA2D26 [a_sw_p_sp6] [sw_p_sp6] todig_1v8
AA2D27 [a_sw_p_sp5] [sw_p_sp5] todig_1v8
AA2D28 [a_sw_p_sp4] [sw_p_sp4] todig_1v8
AA2D29 [a_sw_p_sp3] [sw_p_sp3] todig_1v8
AA2D30 [a_sw_p_sp2] [sw_p_sp2] todig_1v8
AA2D31 [a_sw_p_sp1] [sw_p_sp1] todig_1v8
AA2D32 [a_sw_p8] [sw_p8] todig_1v8
AA2D33 [a_sw_p7] [sw_p7] todig_1v8
AA2D34 [a_sw_p6] [sw_p6] todig_1v8
AA2D35 [a_sw_p5] [sw_p5] todig_1v8
AA2D36 [a_sw_p4] [sw_p4] todig_1v8
AA2D37 [a_sw_p3] [sw_p3] todig_1v8
AA2D38 [a_sw_p2] [sw_p2] todig_1v8
AA2D39 [a_sw_p1] [sw_p1] todig_1v8
AA2D40 [a_bit10] [bit10] todig_1v8
AA2D41 [a_bit9] [bit9] todig_1v8
AA2D42 [a_bit8] [bit8] todig_1v8
AA2D43 [a_bit7] [bit7] todig_1v8
AA2D44 [a_bit6] [bit6] todig_1v8
AA2D45 [a_bit5] [bit5] todig_1v8
AA2D46 [a_bit4] [bit4] todig_1v8
AA2D47 [a_bit3] [bit3] todig_1v8
AA2D48 [a_bit2] [bit2] todig_1v8
AA2D49 [a_bit1] [bit1] todig_1v8
AD2A1 [done] [a_done] toana_1v8
AA2D50 [a_sw_sample] [sw_sample] todig_1v8

.ends
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
