UAH-IC-Design-Team/sky130-10-bit-SAR-ADC/xschem/src/controller/controller_xspice_new.spice

* XSpice netlist created from SPICE and liberty sources by spi2xspice.py
.subckt controller a_clk a_sw_n_sp9 a_sw_n_sp8 a_sw_n_sp7 a_sw_n_sp6 a_sw_n_sp5 a_sw_n_sp4 a_sw_n_sp3 a_sw_n_sp2 a_sw_n_sp1 a_VSS a_VDD a_reset a_Vcmp a_sw_n8 a_sw_n7 a_sw_n6 a_sw_n5 a_sw_n4 a_sw_n3 a_sw_n2 a_sw_n1 a_sw_p_sp9 a_sw_p_sp8 a_sw_p_sp7 a_sw_p_sp6 a_sw_p_sp5 a_sw_p_sp4 a_sw_p_sp3 a_sw_p_sp2 a_sw_p_sp1 a_sw_p8 a_sw_p7 a_sw_p6 a_sw_p5 a_sw_p4 a_sw_p3 a_sw_p2 a_sw_p1 a_bit10 a_bit9 a_bit8 a_bit7 a_bit6 a_bit5 a_bit4 a_bit3 a_bit2 a_bit1 a_done a_sw_sample
*.PININFO clk:I sw_n_sp_9..1_:O VSS:B VDD:B reset:I Vcmp:I sw_n_8..1_:O sw_p_sp_9..1_:O sw_p_8..1_:O
*+ bit_10..1_:O done:O sw_sample:O
A95 [cycle1 cycle2 cycle3 cycle4] net2 d_lut_sky130_fd_sc_hd__or4_2
A96 [cycle5 cycle6 cycle7 cycle8] net3 d_lut_sky130_fd_sc_hd__or4_2
A97 [cycle9 cycle10 cycle11 cycle12] net5 d_lut_sky130_fd_sc_hd__or4_2
A62_x3 [raw_bit2 raw_bit1 x3_net1] [x3_net16 x3_net2] d_genlut_sky130_fd_sc_hd__fa_1
A64_x3 [raw_bit3 raw_bit1 x3_net4] [x3_net1 x3_net3] d_genlut_sky130_fd_sc_hd__fa_1
A67_x3 x3_net2 cycle31 NULL ~reset bit2 NULL ddflop
A68_x3 x3_net3 cycle31 NULL ~reset bit3 NULL ddflop
A65_x3 [raw_bit5 raw_bit4 x3_net5] [x3_net4 x3_net6] d_genlut_sky130_fd_sc_hd__fa_1
A69_x3 [raw_bit6 raw_bit4 x3_net8] [x3_net5 x3_net7] d_genlut_sky130_fd_sc_hd__fa_1
A70_x3 x3_net6 cycle31 NULL ~reset bit4 NULL ddflop
A71_x3 x3_net7 cycle31 NULL ~reset bit5 NULL ddflop
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
