UAH-IC-Design-Team/sky130-10-bit-SAR-ADC/xschem/src/controller/controller.v

// sch_path: /foss/designs/sky130-10-bit-SAR-ADC/xschem/src/controller/controller.sch
module controller
(
  output wire sw_p8,
  output wire bit10,
  output wire done,
  output wire sw_sample,
  output wire comparator_clk,
  output wire sw_p_sp9,
  output wire sw_p_sp8,
  output wire sw_p_sp7,
  output wire sw_p_sp6,
  output wire sw_p_sp5,
  output wire sw_p_sp4,
  output wire sw_p_sp3,
  output wire sw_p_sp2,
  output wire sw_p_sp1,
  output wire sw_p7,
  output wire sw_p6,
  output wire sw_p5,
  output wire sw_p4,
  output wire sw_p3,
  output wire sw_p2,
  output wire sw_p1,
  output wire sw_n8,
  output wire sw_n_sp9,
  output wire sw_n_sp8,
  output wire sw_n_sp7,
  output wire sw_n_sp6,
  output wire sw_n_sp5,
  output wire sw_n_sp4,
  output wire sw_n_sp3,
  output wire sw_n_sp2,
  output wire sw_n_sp1,
  output wire sw_n7,
  output wire sw_n6,
  output wire sw_n5,
  output wire sw_n4,
  output wire sw_n3,
  output wire sw_n2,
  output wire sw_n1,
  output wire bit9,
  output wire bit8,
  output wire bit7,
  output wire bit6,
  output wire bit5,
  output wire bit4,
  output wire bit3,
  output wire bit2,
  output wire bit1,
  inout wire VSS,
  inout wire VDD,
  input wire clk,
  input wire reset,
  input wire comp_out_p,
  input wire comp_out_n
);
wire raw_bit10 ;
wire raw_bit11 ;
wire raw_bit12 ;
wire raw_bit13 ;
wire raw_bit_calc_reset ;
wire controller_clk ;
wire raw_bit1 ;
wire raw_bit2 ;
wire raw_bit3 ;
wire raw_bit4 ;
wire raw_bit5 ;
wire raw_bit6 ;
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


buf_2
x1 ( 
 .A( net20 ),
 .X( net21 )
);


buf_4
x2 ( 
 .A( net23 ),
 .X( net22 )
);


buf_8
x3 ( 
 .A( net22 ),
 .X( sw_sample )
);


buf_2
x4 ( 
 .A( net1 ),
 .X( net23 )
);


clkdlybuf4s50_1
x6 ( 
 .A( net24 ),
 .X( net17 )
);


clkdlybuf4s50_1
x28 ( 
 .A( clk ),
 .X( net24 )
);

endmodule

// expanding   symbol:  src/xor_clock_gen/xor_clock_gen.sym # of pins=5
// sym_path: /foss/designs/sky130-10-bit-SAR-ADC/xschem/src/xor_clock_gen/xor_clock_gen.sym
// sch_path: /foss/designs/sky130-10-bit-SAR-ADC/xschem/src/xor_clock_gen/xor_clock_gen.sch
module xor_clock_gen
(
  inout wire VSS,
  input wire Vin_p,
  inout wire VDD,
  input wire Vin_n,
  output wire Gen_clk
);
wire net10 ;
wire net11 ;
wire net1 ;
wire net2 ;
wire net3 ;
wire net4 ;
wire net5 ;
wire net6 ;
wire net7 ;
wire net8 ;
wire net9 ;


xor2_1
x2 ( 
 .A( Vin_p ),
 .B( Vin_n ),
 .X( net1 )
);


clkdlybuf4s50_1
x3 ( 
 .A( net1 ),
 .X( net2 )
);


clkdlybuf4s50_1
x17 ( 
 .A( net2 ),
 .X( net3 )
);


clkbuf_1
x9 ( 
 .A( net11 ),
 .X( net4 )
);


clkbuf_2
x14 ( 
 .A( net4 ),
 .X( net5 )
);


clkbuf_4
x19 ( 
 .A( net5 ),
 .X( net6 )
);


clkbuf_8
x26 ( 
 .A( net6 ),
 .X( net7 )
);


clkbuf_16
x27 ( 
 .A( net7 ),
 .X( Gen_clk )
);


clkdlybuf4s50_1
x1 ( 
 .A( net3 ),
 .X( net9 )
);


clkdlybuf4s50_1
x4 ( 
 .A( net9 ),
 .X( net8 )
);


clkdlybuf4s50_1
x5 ( 
 .A( net8 ),
 .X( net10 )
);


clkdlybuf4s50_1
x6 ( 
 .A( net10 ),
 .X( net11 )
);

endmodule

// expanding   symbol:  src/demux2/demux2.sym # of pins=6
// sym_path: /foss/designs/sky130-10-bit-SAR-ADC/xschem/src/demux2/demux2.sym
// sch_path: /foss/designs/sky130-10-bit-SAR-ADC/xschem/src/demux2/demux2.sch
module demux2
(
  input wire S,
  inout wire VDD,
  inout wire VSS,
  output wire OUT_0,
  input wire IN,
  output wire OUT_1
);
wire net1 ;


and2_0
x1 ( 
 .A( net1 ),
 .B( IN ),
 .X( OUT_0 )
);


and2_0
x2 ( 
 .A( S ),
 .B( IN ),
 .X( OUT_1 )
);


inv_1
x3 ( 
 .A( S ),
 .Y( net1 )
);

endmodule
