UAH-IC-Design-Team/sky130-10-bit-SAR-ADC/(commit log)

2022-07-05 created demux schematic and symbol
    [demux2.sch]
2022-07-05 started controller
    [controller.sch]
2022-07-05 added DEC logic
    [controller.sch]
2022-07-06 started pulse generator
    [pulse_generator.sch]
2022-07-06 made pulse generator 32 clock cycles long
    [pulse_generator.sch]
2022-07-06 swapped out VPWR and VGND for VCC and GND in sc statements
    [controller.sch]
2022-07-06 changed voltage source language to VDD and VCC
    [pulse_generator.sch]
2022-07-06 swaped voltage source language to VSS and VDD
    [controller.sch]
2022-07-06 fixed the shorts in the pulse generator
    [pulse_generator.sch]
2022-07-06 added the clock pulse generator to the schematic
    [controller.sch]
2022-07-06 added a bunch of ntoes
    [controller.sch]
2022-07-06 Fixed incorrect initial state and got bassic simulation functional
    [controller.sch]
2022-07-06 clean up
    [controller.sch]
2022-07-07 swapped to VSS and VDD voltage source
    [demux2.sch]
2022-07-07 fixed incorrect xschem power system usage
    [controller.sch, demux2.sch]
2022-07-07 created file structure
    [controller.sch, demux2.sch, pulse_generator.sch, pulse_generator_test.sch]
2022-07-07 created default testbench schematic template
    [default_template_test.sch]
2022-07-07 updated pulse_generator test
    [pulse_generator_test.sch]
2022-07-07 updated new pathing for sub modules
    [controller.sch]
2022-07-07 wrote test for demuxer
    [demux2_test.sch]
2022-07-07 split the DEC into a symbol and wrote a test
    [dec.sch, dec_test.sch]
2022-07-07 split the delay line into it's own schematic
    [clock_pulse_delay_line.sch]
2022-07-07 split the clock delay line into it's own schematic
    [clock_pulse_delay_line.sch, clock_pulse_delay_line_test.sch, pulse_generator and_delay_line_test.sch, pulse_generator.sch]
2022-07-07 split out raw_bit_calculator and started test for it
    [raw_bit_calculator.sch, raw_bit_calculator_test.sch]
2022-07-07 split the controller into separate parts
    [controller.sch, controller_not_split.sch]
2022-07-07 started raw_bit_calculator_test and fixed a reset issue
    [controller.sch, controller_test.sch, raw_bit_calculator_test.sch]
2022-07-07 started controller test
    [controller.sch, controller_test.sch]
2022-07-08 working on testing controller
    [controller_test.sch, dec_test.sch, raw_bit_calculator_test.sch]
2022-07-09 changed name to shifted clock generator
    [controller.sch, pulse_generator and_shifted_clock_generator_test.sch, raw_bit_calculator_test.sch, shifted_clock_generator.sch, shifted_clock_generator_test.sch]
2022-07-30 figuring out how to extract netlists for LVS
    [demux2.sch]
2022-08-05 working on new revision
    [controller.sch, controller_test.sch, dec.sch, dec_test.sch, dummy.sch, raw_bit_calculator.sch, raw_bit_calculator_initial_try.sch]
2022-08-05 started comparator
    [comparator.sch, comparator_test.sch, default_template_test.sch]
2022-08-07 roughed in w/ls
    [comparator.sch, comparator_test.sch, dummy.sch]
2022-08-07 testing dflop timing
    [dummy2.sch, dummy3.sch]
2022-08-07 roughed in bootstrapped sampling switch
    [bootstrapped_sampling_switch.sch, bootstrapped_sampling_switch_test.sch, default_template_test.sch]
2022-08-07 rough capacitor switch design
    [capacitor_switch.sch, capacitor_switch_test.sch, default_template_test.sch]
2022-08-07 started capacitor array
    [capacitor_array.sch, capacitor_array_test.sch, default_template_test.sch]
2022-08-08 wrote test for cap array
    [capacitor_array_test.sch]
2022-08-08 put the cap array and switches together in dac
    [dac.sch, dac_test.sch]
2022-08-08 added ports for differential to single ended converter for comparator
    [diff_to_se.sch, diff_to_se_test.sch]
2022-08-08 wired everything together in the sar_adc
    [sar_adc.sch, sar_adc_test.sch]
2022-08-08 made pulse generator same duty cycle as clock
    [pulse_generator.sch, pulse_generator_and_shifted_clock_generator_test.sch, shifted_clock_generator.sch, shifted_clock_generator_test.sch]
2022-08-09 got the switches to run correctly
    [controller.sch, controller_test.sch, raw_bit_calculator.sch]
2022-08-09 corrected sample switching timing
    [controller.sch, controller_test.sch, raw_bit_calculator.sch]
2022-08-09 built a small diff amp
    [diff_to_se.sch, diff_to_se_test.sch]
2022-08-09 testing and updating docs
    [sar_adc.sch, sar_adc_test.sch]
2022-08-10 started working on script
    [sky130A.lyt]
2022-08-15 fixed input signal biasing and corrected mistake in comparator
    [comparator.sch, comparator_test_small_v.sch, latch_sandbox.sch, sar_adc_test.sch]
2022-08-15 added stepped buffers to the comparator output
    [comparator.sch]
2022-08-15 removed Diff to Se
    [diff_to_se.sch, diff_to_se_test.sch, sar_adc.sch]
2022-08-15 increased the switch sizes and added a few tests
    [bootstrapped_sampling_switch.sch, bootstrapped_sampling_switch_test.sch, bootstrapped_sampling_switch_w_caps_test.sch]
2022-08-15 created different sized capacitor switches
    [capacitor_switch16.sch, capacitor_switch16_test.sch, capacitor_switch2.sch, capacitor_switch2_test.sch, capacitor_switch4.sch, capacitor_switch4_test.sch, capacitor_switch8.sch, capacitor_switch8_test.sch]
2022-08-17 got the XOR clock gen working, started adjusting controller
    [controller.sch, controller_test.sch, sar_adc.sch, sar_adc_test.sch, xor_clock_gen.sch, xor_clock_gen_test.sch, xor_clock_gen_timing_test.sch]
2022-08-19 battling spice stupidities
    [controller.sch, controller_test2.sch, demux2_switching_test.sch, dummy_dff_set_test.sch, dummy_reset_threshold.sch, pulse_generator_and_shifted_clock_generator_test.sch, raw_bit_calculator.sch, sar_adc.sch]
2022-08-20 Created a edge only shifted clock gen
    [shifted_clock_generator2.sch, shifted_clock_generator_test.sch]
2022-08-20 simplified xor clock gen
    [xor_clock_gen.sch, xor_clock_gen_test.sch, xor_clock_gen_timing_test.sch]
2022-08-20 measured delay of each delay component
    [dummy_clkdly_test.sch]
2022-08-22 working on getting xSpice simulations
    [controller.sch, controller_test.sch, controller_test_with_xor.sch, pulse_generator.sch]
2022-08-28 got demux2 xspice to work
    [xor_clock_gen.sch]
2022-09-08 abaondoned xschem, but left code. Got ngspice sorta functional
    [all_analog_test.sch, all_analog_wo_dac_test.sch, bootstrapped_sampling_switch.sch, bootstrapped_sampling_switch_load_test.sch, comparator.sch, comparator_dac_sw_test.sch, comparator_dac_test.sch, comparator_sw_test.sch]
2022-09-09 removed unused modules, organized, updated docs and added extra reset
    [all_analog_test.sch, controller.sch, dummy.sch, dummy2.sch, dummy3.sch, dummy_clkdly_test.sch, dummy_dff_set_test.sch, dummy_reset_threshold.sch]
2022-09-11 Semi functional design. Odd spice stuff with dflops not triggering
    [controller.sch, controller_test.sch, dummy3.sch, raw_bit_calculator.sch, sample_clock.sch, sar_adc.sch, sar_adc_test.sch, shifted_clock_generator.sch]
2022-09-11 fixed a lot of overlapping labs. Corner splitting in sar_adc_test and set up uic tran
    [bootstrapped_sampling_switch.sch, bootstrapped_sampling_switch_load_test.sch, comparator_dac_sw_test.sch, comparator_sw_test.sch, comparator_test.sch, comparator_test_small_v.sch, controller.sch, controller_test.sch]
2022-09-12 closer, but shifted clock gen isn't always clocking
    [comparator_power_ramp_in_test.sch, loading_dflop_test.sch, sample_clock.sch, sar_adc_test.sch, shifted_clock_generator.sch]
2022-09-14 testing xor_clk cap stuff
    [comparator_test.sch, controller.sch, raw_bit_calculator.sch, sar_adc.sch, xor_clock_gen.sch, xor_clock_gen_clkbuf_w_cap.sch, xor_clock_gen_normal_buf.sch, xor_clock_gen_test.sch]
2022-09-15 Stepped test with validation
    [comparator_stepped_test.sch, comparator_test.sch]
2022-09-15 playing with stepped parameters with a mos
    [most_stepped_test.sch]
2022-09-15 started bootstrapped fft
    [bootstrapped_sampling_switch.sch, bootstrapped_sfdr_test.sch]
2022-09-16 controller corner tests
    [bootstrapped_sfdr_test.sch, controller_corner_ff_test.sch, controller_corner_fs_test.sch, controller_corner_sf_test.sch, controller_corner_ss_test.sch, shifted_clock_generator.sch]
2022-09-16 the adc is working
    [comparator.sch, comparator_test_small_v.sch, dff_timing.sch, intdiff_weird.sch, sar_adc_test.sch, xor_clock_gen.sch, xor_clock_gen__only_xor_test.sch, xor_clock_gen_only_xor.sch]
2022-09-18 functional stepped sar adc test
    [comparator_stepped_test2.sch, mos_meas_stepped_test.sch, sar_adc_code_step_test.sch]
2022-09-23 updated controller test sample rate successfully
    [controller_corner_ff_test.sch, controller_corner_fs_test.sch, controller_corner_sf_test.sch, controller_corner_ss_test.sch, controller_power_ramp_in_test.sch, controller_test_with_xor.sch]
2022-09-23 reduced dac unit cap size to something reasonable
    [dac.sch]
2022-09-23 fixed bad reset feedback
    [controller.sch, shifted_clock_generator.sch]
2022-09-23 adjusted stupid spice cap in xor_clock_gen to work
    [sample_clock.sch, xor_clock_gen.sch]
2022-09-23 working sar_adc at low freq
    [bootstrapped_sampling_switch.sch, bootstrapped_sampling_switch_test.sch, comparator.sch, dummy_clkdly_test.sch, sar_adc.sch, sar_adc_code_step_test.sch, sar_adc_test.sch, xor_clock_gen.sch]
2022-09-24 adjusted test for aws
    [sar_adc_code_step_test.sch]
2022-09-24 increasing speed of sar_adc
    [comparator.sch, comparator_fast_test.sch, comparator_single_value_test.sch, comparator_stepped_test.sch, sar_adc_code_step_max_sample_rate_test.sch, sar_adc_fft_test.sch, sar_adc_max_sample_rate_test.sch, sar_adc_mid_sample_rate_test.sch]
2022-09-28 added sine test and corrected bad iteration test
    [mos_meas_stepped_test.sch, sar_adc_code_step_iterated_test.sch, sar_adc_code_step_non_iterated_test.sch, sar_adc_sine_test.sch, sar_adc_test.sch]
2022-09-28 cleaned up bootstrapped tests and added corner splitting to default template
    [bootstrapped_sampling_switch_load_test.sch, bootstrapped_sampling_switch_test.sch, bootstrapped_sampling_switch_w_caps_test.sch, bootstrapped_sfdr_test.sch, default_template_test.sch]
2022-09-28 tuning comparator faster
    [comparator.sch, comparator_fast_small_v_test.sch]
2022-09-28 wrote sample_clock test
    [sample_clock_test.sch]
2022-09-28 added test for reset and 2 bits
    [sar_adc_2bits_test.sch, xor_comparator.sch]
2022-09-28 cleaning up tests
    [capacitor_array_test.sch, capacitor_switch16_test.sch, capacitor_switch2_test.sch, capacitor_switch4_test.sch, capacitor_switch8_test.sch, comparator_sw_test.sch, dac_test.sch, dec_test.sch]
2022-09-28 adjusted timing in sample_clock
    [sample_clock.sch]
2022-09-28 upped sample rate to max
    [sar_adc_max_sample_rate_test.sch]
2022-09-28 cleaned up schematics
    [bootstrapped_sampling_switch.sch, capacitor_array.sch, comparator.sch, controller.sch, dac.sch, dec.sch, demux2.sch, raw_bit_calculator.sch]
2022-09-29 fixing xor cap adjust for high clock
    [all_analog_test.sch, all_analog_wo_dac_test.sch, capacitor_array_test.sch, comparator.sch, comparator_dac_test.sch, comparator_fast_small_v_offset_test.sch, controller_xor_comparator.sch, sample_clock.sch]
2022-09-29 circuit images
2022-09-30 created power test
    [sar_adc_max_sample_power_test.sch]
2022-09-30 cleaned up xor_clk_gen dir
    [xor_clock_gen_fast.sch, xor_clock_gen_slow.sch]
2022-09-30 cleaned up simualations and built a comparator with LVT for fun
    [comparator_fast_cap_loaded_input_test.sch, comparator_fast_large_swing_test.sch, comparator_fast_low_vt_small_v_test.sch, comparator_fast_low_vt_test.sch, comparator_low_vt.sch, controller_corner_ff_test.sch, controller_corner_fs_test.sch, dac_test.sch]
2022-10-08 started laying out capacitor array
2022-10-11 added save all to all tests
    [bootstrapped_sampling_switch_load_test.sch, bootstrapped_sampling_switch_test.sch, bootstrapped_sampling_switch_w_caps_test.sch, capacitor_array_test.sch, capacitor_switch16_test.sch, capacitor_switch2_test.sch, capacitor_switch4_test.sch, capacitor_switch8_test.sch]
2022-10-20 built a cap array and started switches but the cap array has too high m3 density
2022-10-21 got a probably functional capacitor array
2022-10-23 layed out capacitor switches
    [capacitor_array.sch]
2022-10-27 started bootstrapped switch
    [bootstrapped_sampling_switch.sch, sar_adc_code_step_max_sample_test.sch, sar_adc_sine_max_sample_test.sch, sar_adc_test.sch, xor_clock_gen_test.sch]
2022-10-28 passing LVS and DRC bootstrapped switch
    [bootstrapped_sampling_switch.sch]
2022-11-04 continued working on comparator and started ESD design
    [controller.sch, dummy_diod.sch, esd_diodes.sch, ggmos_esd.sch, sar_adc.sch, sar_adc_test.sch, xor_clock_gen.sch]
2022-11-06 comparator passes lvs
    [comparator.sch]
2022-11-07 removed cap from xor_clock_gen, clean up
    [xor_clock_gen.sch]
2022-11-07 swapped out busses for normal schematic wires and added comb in shifted clockgen
    [controller.sch, controller_test.sch, dec.sch, raw_bit_calculator.sch, sar_adc.sch, shifted_clock_generator.sch]
2022-11-12 final gds
    [all_analog.sch, dac.sch, dac_test.sch, dummy_diode_std_cell.sch, sar_adc.sch, sar_adc_test.sch]
2022-11-12 build esd diodes
    [esd_diodes.sch]
